NovaPrime18/Twin-GaN/production/bom-after-1210-to-0805.csv

Reference | Value | Footprint | LCSC | Manufacturer Part Number
C1 | 100nF | Capacitor_SMD:C_0402_1005Metric | C307331
C2 | 10uF | Capacitor_SMD:C_0805_2012Metric | C440198
C3 | 100nF | Capacitor_SMD:C_0402_1005Metric | C307331
C4 | 100nF | Capacitor_SMD:C_0402_1005Metric | C307331
C5 | 100nF | Capacitor_SMD:C_0402_1005Metric | C307331
C6 | 100nF | Capacitor_SMD:C_0402_1005Metric | C307331
C7 | 100nF | Capacitor_SMD:C_0402_1005Metric | C307331
C8 | 10uF | Capacitor_SMD:C_0805_2012Metric | C440198
C9 | 2.2uF | Capacitor_SMD:C_0402_1005Metric | C20539421
C10 | 2.2uF | Capacitor_SMD:C_0402_1005Metric | C20539421
C11 | 15pF | Capacitor_SMD:C_0402_1005Metric | C1548
C12 | 15pF | Capacitor_SMD:C_0402_1005Metric | C1548
C13 | 2.2uF | Capacitor_SMD:C_0402_1005Metric | C20539421
C14 | 2.2uF 100V | Capacitor_SMD:C_1206_3216Metric | C170101
C15 | 100nF | Capacitor_SMD:C_0402_1005Metric | C307331
C16 | 100nF | Capacitor_SMD:C_0402_1005Metric | C307331
C17 | 10uF | Capacitor_SMD:C_0805_2012Metric | C440198
C18 | 100nF | Capacitor_SMD:C_0402_1005Metric | C307331
C19 | 2.2uF | Capacitor_SMD:C_0402_1005Metric | C20539421
C20 | 100nF | Capacitor_SMD:C_0402_1005Metric | C307331
C21 | 2.2uF 100V | Capacitor_SMD:C_1206_3216Metric | C170101
C22 | 100nF | Capacitor_SMD:C_0402_1005Metric | C307331
C23 | 2.2uF | Capacitor_SMD:C_0402_1005Metric | C20539421
C24 | 100nF | Capacitor_SMD:C_0402_1005Metric | C307331
C25 | 2.2uF 100V | Capacitor_SMD:C_1206_3216Metric | C170101
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
C95 | 2.2uF | Capacitor_SMD:C_0402_1005Metric | C20539421
C96 | 2.2uF | Capacitor_SMD:C_0402_1005Metric | C20539421
C97 | 100nF | Capacitor_SMD:C_0402_1005Metric | C307331
C98 | 100nF | Capacitor_SMD:C_0402_1005Metric | C307331
C99 | 100nF | Capacitor_SMD:C_0402_1005Metric | C307331
C100 | 2.2uF 100V | Capacitor_SMD:C_1206_3216Metric | C170101
C101 | 2.2uF 100V | Capacitor_SMD:C_1206_3216Metric | C170101
C102 | 2.2uF 100V | Capacitor_SMD:C_1206_3216Metric | C170101
C103 | 100nF | Capacitor_SMD:C_0402_1005Metric | C307331
C104 | 100nF | Capacitor_SMD:C_0402_1005Metric | C307331
C105 | 100nF | Capacitor_SMD:C_0402_1005Metric | C307331
C106 | 100nF | Capacitor_SMD:C_0402_1005Metric | C307331
C107 | 100nF | Capacitor_SMD:C_0402_1005Metric | C307331
C108 | 100nF | Capacitor_SMD:C_0402_1005Metric | C307331
C109 | 100nF | Capacitor_SMD:C_0402_1005Metric | C307331
C110 | 100uF 80V | Capacitor_SMD:CP_Elec_10x10 | C487410
C111 | 100uF 80V | Capacitor_SMD:CP_Elec_10x10 | C487410
C112 | 100uF 80V | Capacitor_SMD:CP_Elec_10x10 | C487410
C113 | 100uF 80V | Capacitor_SMD:CP_Elec_10x10 | C487410
C115 | 100uF 80V | Capacitor_SMD:CP_Elec_10x10 | C487410
C116 | 100uF 80V | Capacitor_SMD:CP_Elec_10x10 | C487410
C117 | 100uF 80V | Capacitor_SMD:CP_Elec_10x10 | C487410
C118 | 100uF 80V | Capacitor_SMD:CP_Elec_10x10 | C487410
D1 | Red | LED_SMD:LED_0603_1608Metric | C2286
D2 | Green | LED_SMD:LED_0603_1608Metric | C84267
D4 | BAV16W | Diode_SMD:D_SOD-123 | C459527
D5 | Red | LED_SMD:LED_0603_1608Metric | C2286
D6 | Green | LED_SMD:LED_0603_1608Metric | C84267
D7 | BAV16W | Diode_SMD:D_SOD-123 | C459527
D8 | BAV16W | Diode_SMD:D_SOD-123 | C459527
D14 | MBR1H100SFT3G | Diode_SMD:D_SOD-123F | C235757 | MBR1H100SFT3G
D22 | LED | LED_SMD:LED_0603_1608Metric | C2286
D23 | MBR1H100SFT3G | Diode_SMD:D_SOD-123F | C235757 | MBR1H100SFT3G
D24 | LED | LED_SMD:LED_0603_1608Metric | C2286
D25 | LED | LED_SMD:LED_0603_1608Metric | C2286
F2 | 0.5A | Resistor_SMD:R_0805_2012Metric | C2833485
F3 | 0.5A | Resistor_SMD:R_0805_2012Metric | C2833485
F4 | 0.5A | Resistor_SMD:R_0805_2012Metric | C2833485
FB2 | 600R@100MHz | Inductor_SMD:L_0402_1005Metric | C76884
FB3 | 600R@100MHz | Inductor_SMD:L_0402_1005Metric | C76884
FB4 | 600R@100MHz | Inductor_SMD:L_0402_1005Metric | C76884
J1 | Conn_01x03 | Connector_AMASS:AMASS_MR30PW-M_1x03_P3.50mm_Horizontal
J3 | Conn_01x04 | Connector_AMASS:AMASS_XT90PW-M_1x02_P10.90mm_Horizontal
J4 | Hall | Connector_JST:JST_PH_B6B-PH-SM4-TB_1x06-1MP_P2.00mm_Vertical | C471518
J5 | COMM | Connector_JST:JST_PH_B8B-PH-SM4-TB_1x08-1MP_P2.00mm_Vertical | C495548
J7 | Connector, USB-TYPE-C-16P | PCM_JLCPCB:TYPE-C-SMD_HX-TYPE-C-16PIN | C2927039
J9 | Hall | Connector_JST:JST_PH_B6B-PH-SM4-TB_1x06-1MP_P2.00mm_Vertical | C471518
J10 | COMM | Connector_JST:JST_PH_B8B-PH-SM4-TB_1x08-1MP_P2.00mm_Vertical | C495548
J11 | Conn_01x03 | Connector_AMASS:AMASS_MR30PW-M_1x03_P3.50mm_Horizontal
J12 | Connector, USB-TYPE-C-16P | PCM_JLCPCB:TYPE-C-SMD_HX-TYPE-C-16PIN | C2927039
J13 | Connector, USB-TYPE-C-16P | PCM_JLCPCB:TYPE-C-SMD_HX-TYPE-C-16PIN | C2927039
L2 | 22uH 1A 0.29Ohm | Inductor_SMD:L_Sunlord_SWPA4030S | C83472 | SWPA4030S220MT
L3 | 22uH 1A 0.29Ohm | Inductor_SMD:L_Sunlord_SWPA4030S | C83472 | SWPA4030S220MT
R1 | 22 | Resistor_SMD:R_0402_1005Metric | C25092
R2 | 1k | Resistor_SMD:R_0402_1005Metric | C11702
R3 | 1k | Resistor_SMD:R_0402_1005Metric | C11702
R10 | 4.7 | Resistor_SMD:R_0402_1005Metric | C25121
R11 | 10k | Resistor_SMD:R_0402_1005Metric | C25744
R12 | 10k | Resistor_SMD:R_0402_1005Metric | C25744
R13 | 22 | Resistor_SMD:R_0402_1005Metric | C25092
R14 | 10k | Resistor_SMD:R_0402_1005Metric | C25744
R15 | 10k | Resistor_SMD:R_0402_1005Metric | C25744
R16 | 22 | Resistor_SMD:R_0402_1005Metric | C25092
R17 | 1k | Resistor_SMD:R_0402_1005Metric | C11702
R18 | 1k | Resistor_SMD:R_0402_1005Metric | C11702
R19 | 22 | Resistor_SMD:R_0402_1005Metric | C25092
R20 | 22 | Resistor_SMD:R_0402_1005Metric | C25092
R21 | 22 | Resistor_SMD:R_0402_1005Metric | C25092
R22 | 22 | Resistor_SMD:R_0402_1005Metric | C25092
R23 | 22 | Resistor_SMD:R_0402_1005Metric | C25092
R30 | 4.7 | Resistor_SMD:R_0402_1005Metric | C25121
R31 | 10k | Resistor_SMD:R_0402_1005Metric | C25744
R32 | 10k | Resistor_SMD:R_0402_1005Metric | C25744
R33 | 10k | Resistor_SMD:R_0402_1005Metric | C25744
R34 | 10k | Resistor_SMD:R_0402_1005Metric | C25744
R35 | 56k | Resistor_SMD:R_0603_1608Metric | C23206
R36 | 2k2 | Resistor_SMD:R_0402_1005Metric | C25879
R37 | 56k | Resistor_SMD:R_0603_1608Metric | C23206
R38 | 2k2 | Resistor_SMD:R_0402_1005Metric | C25879
R39 | 56k | Resistor_SMD:R_0603_1608Metric | C23206
R40 | 2k2 | Resistor_SMD:R_0402_1005Metric | C25879
R41 | 220 | Resistor_SMD:R_0603_1608Metric | C22962
R42 | 22 | Resistor_SMD:R_0402_1005Metric | C25092
R43 | 22 | Resistor_SMD:R_0402_1005Metric | C25092
R44 | 22 | Resistor_SMD:R_0402_1005Metric | C25092
R45 | 22 | Resistor_SMD:R_0402_1005Metric | C25092
R46 | 22 | Resistor_SMD:R_0402_1005Metric | C25092
R47 | 22 | Resistor_SMD:R_0402_1005Metric | C25092
R48 | 10k | Resistor_SMD:R_0402_1005Metric | C25744
R49 | 10k | Resistor_SMD:R_0402_1005Metric | C25744
R50 | 10k | Resistor_SMD:R_0402_1005Metric | C25744
R51 | 100k | Resistor_SMD:R_0402_1005Metric | C60491
R52 | 10 | Resistor_SMD:R_0402_1005Metric | C25077
R53 | 10 | Resistor_SMD:R_0402_1005Metric | C25077
R54 | 10 | Resistor_SMD:R_0402_1005Metric | C25077
R55 | 10 | Resistor_SMD:R_0402_1005Metric | C25077
R56 | 10 | Resistor_SMD:R_0402_1005Metric | C25077
R57 | 10 | Resistor_SMD:R_0402_1005Metric | C25077
R58 | 56k | Resistor_SMD:R_0603_1608Metric | C23206
R59 | 2k2 | Resistor_SMD:R_0402_1005Metric | C25879
R60 | 22 | Resistor_SMD:R_0402_1005Metric | C25092
R61 | 22 | Resistor_SMD:R_0402_1005Metric | C25092
R62 | 22 | Resistor_SMD:R_0402_1005Metric | C25092
R63 | 22 | Resistor_SMD:R_0402_1005Metric | C25092
R64 | 22 | Resistor_SMD:R_0402_1005Metric | C25092
R65 | 22 | Resistor_SMD:R_0402_1005Metric | C25092
R66 | 10 | Resistor_SMD:R_0402_1005Metric | C25077
R67 | 1k | Resistor_SMD:R_0402_1005Metric | C11702
R68 | 1k | Resistor_SMD:R_0402_1005Metric | C11702
R69 | 10 | Resistor_SMD:R_0402_1005Metric | C25077
R70 | 10 | Resistor_SMD:R_0402_1005Metric | C25077
R71 | 10 | Resistor_SMD:R_0402_1005Metric | C25077
R72 | 1k | Resistor_SMD:R_0402_1005Metric | C11702
R73 | 1k | Resistor_SMD:R_0402_1005Metric | C11702
R74 | 10k @25°C | Resistor_SMD:R_0402_1005Metric | C77131
R75 | 10k @25°C | Resistor_SMD:R_0402_1005Metric | C77131
R76 | 10k @25°C | Resistor_SMD:R_0402_1005Metric | C77131
R77 | 1k | Resistor_SMD:R_0402_1005Metric | C106235
R78 | 1k | Resistor_SMD:R_0402_1005Metric | C11702
R79 | 50k | Resistor_SMD:R_0402_1005Metric | C25897
R80 | 1k | Resistor_SMD:R_0402_1005Metric | C11702
R81 | 10k @25°C | Resistor_SMD:R_0402_1005Metric | C77131
R82 | 10k @25°C | Resistor_SMD:R_0402_1005Metric | C77131
R83 | 10k @25°C | Resistor_SMD:R_0402_1005Metric | C77131
R84 | 33k 1% | Resistor_SMD:R_0402_1005Metric | C138003 | RC0402FR-0733KL
R85 | 4.7k 1% | Resistor_SMD:R_0402_1005Metric | C105871 | 0402WGF1003TCE
R86 | 33k 1% | Resistor_SMD:R_0402_1005Metric | C138003 | RC0402FR-0733KL
R87 | 10 | Resistor_SMD:R_0402_1005Metric | C25077
R88 | 10 | Resistor_SMD:R_0402_1005Metric | C25077
R89 | 56k | Resistor_SMD:R_0603_1608Metric | C23206
R90 | 2k2 | Resistor_SMD:R_0402_1005Metric | C25879
R91 | 56k | Resistor_SMD:R_0603_1608Metric | C23206
R92 | 10k | Resistor_SMD:R_0402_1005Metric | C2906861
R93 | 54.9k 1% | Resistor_SMD:R_0402_1005Metric | C11626
R94 | 10k | Resistor_SMD:R_0402_1005Metric | C2906861
R95 | 1k | Resistor_SMD:R_0402_1005Metric | C106235
R96 | 2k2 | Resistor_SMD:R_0402_1005Metric | C25879
R97 | 2mR | Resistor_SMD:R_1206_3216Metric | C601094
R98 | 2mR | Resistor_SMD:R_1206_3216Metric | C601094
R99 | 2mR | Resistor_SMD:R_1206_3216Metric | C601094
R100 | 2mR | Resistor_SMD:R_1206_3216Metric | C601094
R101 | 2mR | Resistor_SMD:R_1206_3216Metric | C601094
R102 | 2mR | Resistor_SMD:R_1206_3216Metric | C601094
R103 | 56k | Resistor_SMD:R_0603_1608Metric | C23206
R104 | 2k2 | Resistor_SMD:R_0402_1005Metric | C25879
R105 | 5.1k | Resistor_SMD:R_0402_1005Metric | C25905
R106 | 5.1k | Resistor_SMD:R_0402_1005Metric | C25905
R107 | 5.1k | Resistor_SMD:R_0402_1005Metric | C25905
R108 | 5.1k | Resistor_SMD:R_0402_1005Metric | C25905
R109 | 5.1k | Resistor_SMD:R_0402_1005Metric | C25905
R110 | 5.1k | Resistor_SMD:R_0402_1005Metric | C25905
SW1 | KMR211NGLFS | Button_Switch_SMD:SW_Push_1P1T_NO_CK_KMR2 | C221676
SW2 | KMR211NGLFS | Button_Switch_SMD:SW_Push_1P1T_NO_CK_KMR2 | C221676
U1 | STM32F405RGTx | Package_QFP:LQFP-64_10x10mm_P0.5mm | C15742
U2 | EPC23102 | Thommys-Parts:D0727
U3 | INA240A1D | Package_SO:SOIC-8_3.9x4.9mm_P1.27mm | C1346458
U4 | STM32F405RGTx | Package_QFP:LQFP-64_10x10mm_P0.5mm | C15742
U5 | EPC23102 | Thommys-Parts:D0727
U6 | EPC23102 | Thommys-Parts:D0727
U7 | TJA1051TK-3 | Package_SON:HVSON-8-1EP_3x3mm_P0.65mm_EP1.6x2.4mm | C2875699
U8 | ESP32-C3-WROOM-02 | RF_Module:ESP32-C3-WROOM-02 | C2934560
U9 | INA240A1D | Package_SO:SOIC-8_3.9x4.9mm_P1.27mm | C1346458
U10 | 74LVC1G66 | Package_TO_SOT_SMD:SOT-353_SC-70-5 | C97489
U11 | 74LVC1G66 | Package_TO_SOT_SMD:SOT-353_SC-70-5 | C97489
U12 | 74LVC1G66 | Package_TO_SOT_SMD:SOT-353_SC-70-5 | C97489
U13 | 74LVC1G66 | Package_TO_SOT_SMD:SOT-353_SC-70-5 | C97489
U14 | 74LVC1G66 | Package_TO_SOT_SMD:SOT-353_SC-70-5 | C97489
U15 | LMR16006XDDCR | Package_TO_SOT_SMD:SOT-23-6 | C87080 | LMR16006XDDCR
U16 | LMR16006XDDCR | Package_TO_SOT_SMD:SOT-23-6 | C87080 | LMR16006XDDCR
U17 | 74LVC1G66 | Package_TO_SOT_SMD:SOT-353_SC-70-5 | C97489
U18 | EPC23102 | Thommys-Parts:D0727
U19 | INA240A1D | Package_SO:SOIC-8_3.9x4.9mm_P1.27mm | C1346458
U20 | 74LVC1G66 | Package_TO_SOT_SMD:SOT-353_SC-70-5 | C97489
U21 | 74LVC1G66 | Package_TO_SOT_SMD:SOT-353_SC-70-5 | C97489
U22 | 74LVC1G66 | Package_TO_SOT_SMD:SOT-353_SC-70-5 | C97489
U23 | 74LVC1G66 | Package_TO_SOT_SMD:SOT-353_SC-70-5 | C97489
U24 | 74LVC1G66 | Package_TO_SOT_SMD:SOT-353_SC-70-5 | C97489
U25 | 74LVC1G66 | Package_TO_SOT_SMD:SOT-353_SC-70-5 | C97489
U26 | EPC23102 | Thommys-Parts:D0727
U27 | EPC23102 | Thommys-Parts:D0727
U28 | INA240A1D | Package_SO:SOIC-8_3.9x4.9mm_P1.27mm | C1346458
U29 | INA240A1D | Package_SO:SOIC-8_3.9x4.9mm_P1.27mm | C1346458
U30 | INA240A1D | Package_SO:SOIC-8_3.9x4.9mm_P1.27mm | C1346458
U31 | TJA1051TK-3 | Package_SON:HVSON-8-1EP_3x3mm_P0.65mm_EP1.6x2.4mm | C2875699
U32 | TJA1051TK-3 | Package_SON:HVSON-8-1EP_3x3mm_P0.65mm_EP1.6x2.4mm | C2875699
Y1 | 8M | Crystal:Crystal_SMD_3225-4Pin_3.2x2.5mm | C2682775
Y2 | 8M | Crystal:Crystal_SMD_3225-4Pin_3.2x2.5mm | C2682775
