NovaPrime18/Twin-GaN/Twin-GaN-VESC.kicad_pcb

## KiCad design Twin-GaN-VESC.kicad_pcb (2026-10-15)

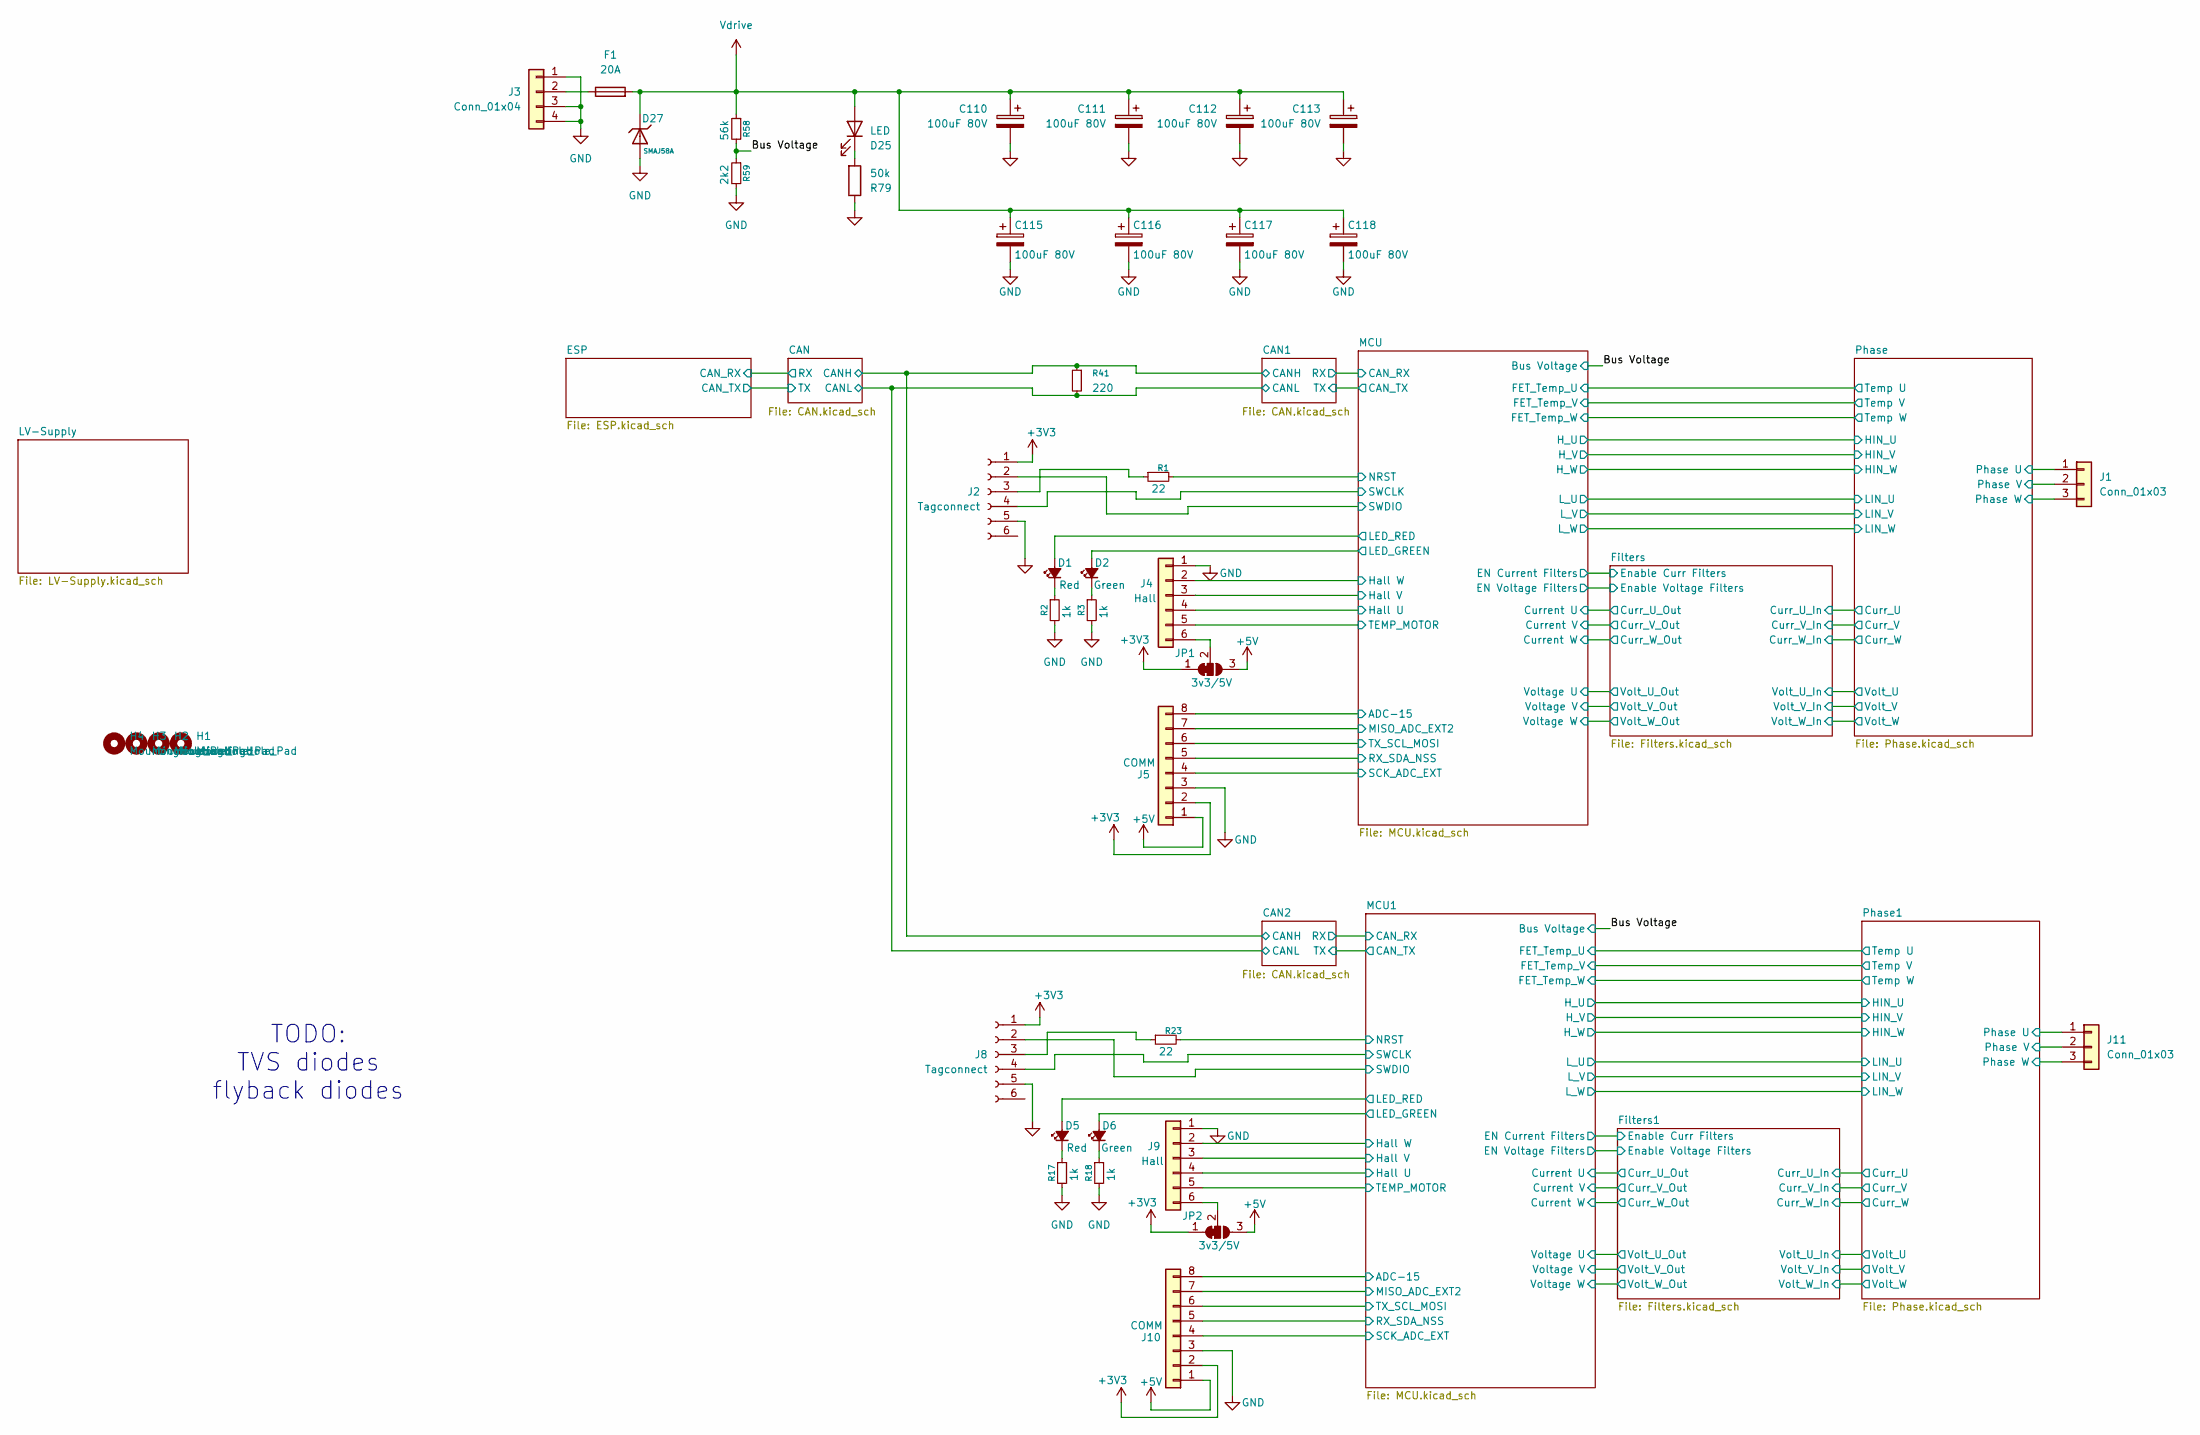
[picture p3: schematic Twin-GaN-VESC.kicad_sch, Twin-GaN]

Parts:
C110, C111, C112, C113, C115, C116, C117, C118: 100uF 80V; CP_Elec_10x10; LCSC C487410
D1, D5: Red; LED_0603_1608Metric; LCSC C2286
D2, D6: Green; LED_0603_1608Metric; LCSC C84267
D25: LED; LED_0603_1608Metric; LCSC C2286
D27: SMAJ58A; D_SMA; Part SMAJ58A; LCSC C19077554
F1: 20A; Fuse_2512_6332Metric; LCSC C49269483
H1, H2, H3, H4: MountingHole_Pad; MountingHole_2.7mm_M2.5
J1, J11: Conn_01x03; AMASS_MR30PW-M_1x03_P3.50mm_Horizontal
J2, J8: Tagconnect; Tag-Connect_TC2030-IDC-NL_2x03_P1.27mm_Vertical
J3: Conn_01x04; AMASS_XT60IPW-M_1x03_P7.20mm_Horizontal
J4, J9: Hall; JST_PH_B6B-PH-SM4-TB_1x06-1MP_P2.00mm_Vertical; LCSC C471518
J5, J10: COMM; JST_PH_B8B-PH-SM4-TB_1x08-1MP_P2.00mm_Vertical; LCSC C495548
JP1, JP2: 3v3/5V; SolderJumper-3_P1.3mm_Bridged12_RoundedPad1.0x1.5mm
R1, R23: 22; R_0402_1005Metric; LCSC C25092
R2, R3, R17, R18: 1k; R_0402_1005Metric; LCSC C11702
R41: 220; R_0603_1608Metric; LCSC C22962
R58: 56k; R_0603_1608Metric; LCSC C23206
R59: 2k2; R_0402_1005Metric; LCSC C25879
R79: 50k; R_0402_1005Metric; LCSC C25897

Connections:
+3V3: J2.1, J5.2, J8.1, J10.2, JP1.1 (A), JP2.1 (A); also elsewhere on the board
+5V: J5.1, J10.1, JP1.3 (B), JP2.3 (B); also elsewhere on the board
/Bus Voltage: R58.2, R59.1; also elsewhere on the board
/CAN/CANH: R41.1; also elsewhere on the board
/CAN/CANL: R41.2; also elsewhere on the board
/MCU1/ADC-15: J10.8; also elsewhere on the board
/MCU1/Hall U: J9.4; also elsewhere on the board
/MCU1/Hall V: J9.3; also elsewhere on the board
/MCU1/Hall W: J9.2; also elsewhere on the board
/MCU1/LED_GREEN: D6.2 (A); also elsewhere on the board
/MCU1/LED_RED: D5.2 (A); also elsewhere on the board
/MCU1/MISO_ADC_EXT2: J10.7; also elsewhere on the board
/MCU1/NRST: R23.2; also elsewhere on the board
/MCU1/RX_SDA_NSS: J10.5; also elsewhere on the board
/MCU1/SCK_ADC_EXT: J10.4; also elsewhere on the board
/MCU1/SWCLK: J8.4; also elsewhere on the board
/MCU1/SWDIO: J8.2; also elsewhere on the board
/MCU1/TEMP_MOTOR: J9.5; also elsewhere on the board
/MCU1/TX_SCL_MOSI: J10.6; also elsewhere on the board
/MCU/ADC-15: J5.8; also elsewhere on the board
/MCU/Hall U: J4.4; also elsewhere on the board
/MCU/Hall V: J4.3; also elsewhere on the board
/MCU/Hall W: J4.2; also elsewhere on the board
/MCU/LED_GREEN: D2.2 (A); also elsewhere on the board
/MCU/LED_RED: D1.2 (A); also elsewhere on the board
/MCU/MISO_ADC_EXT2: J5.7; also elsewhere on the board
/MCU/NRST: R1.2; also elsewhere on the board
/MCU/RX_SDA_NSS: J5.5; also elsewhere on the board
/MCU/SCK_ADC_EXT: J5.4; also elsewhere on the board
/MCU/SWCLK: J2.4; also elsewhere on the board
/MCU/SWDIO: J2.2; also elsewhere on the board
/MCU/TEMP_MOTOR: J4.5; also elsewhere on the board
/MCU/TX_SCL_MOSI: J5.6; also elsewhere on the board
/Phase1/Phase U: J11.1; also elsewhere on the board
/Phase1/Phase V: J11.2; also elsewhere on the board
/Phase1/Phase W: J11.3; also elsewhere on the board
/Phase/Phase U: J1.1; also elsewhere on the board
/Phase/Phase V: J1.2; also elsewhere on the board
/Phase/Phase W: J1.3; also elsewhere on the board
GND: C110.2, C111.2, C112.2, C113.2, C115.2, C116.2, C117.2, C118.2, D27.2, J2.5, J3.1, J3.3, J3.4, J4.1, J5.3, J8.5, J9.1, J10.3, R2.2, R3.2, R17.2, R18.2, R59.2, R79.1; also elsewhere on the board
unnamed: D1.1 (K), R2.1
unnamed: D2.1 (K), R3.1
unnamed: D5.1 (K), R17.1
unnamed: D6.1 (K), R18.1
unnamed: D25.1 (K), R79.2
unnamed: J2.3, R1.1
unnamed: F1.1, J3.2
unnamed: J4.6, JP1.2 (C)
unnamed: J8.3, R23.1
unnamed: J9.6, JP2.2 (C)
Vdrive: C110.1, C111.1, C112.1, C113.1, C115.1, C116.1, C117.1, C118.1, D25.2 (A), D27.1, F1.2, R58.1; also elsewhere on the board

Notes on the sheet:
TODO: TVS diodes flyback diodes

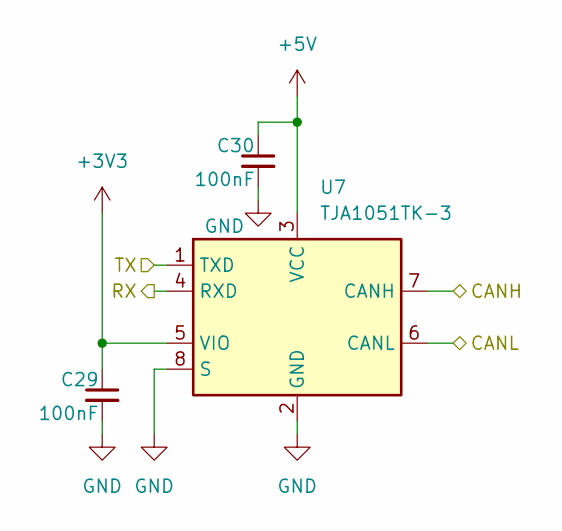
[picture p4: schematic CAN.kicad_sch, Twin-GaN]

Parts:
C29, C30: 100nF; C_0402_1005Metric; LCSC C307331
U7: TJA1051TK-3; HVSON-8-1EP_3x3mm_P0.65mm_EP1.6x2.4mm; JLC C2875699

Connections:
+3V3: C29.1, U7.5 (VIO); also elsewhere on the board
+5V: C30.1, U7.3 (VCC); also elsewhere on the board
/CAN/CANH: U7.7 (CANH); also elsewhere on the board
/CAN/CANL: U7.6 (CANL); also elsewhere on the board
/CAN/RX: U7.4 (RXD); also elsewhere on the board
/CAN/TX: U7.1 (TXD); also elsewhere on the board
GND: C29.2, C30.2, U7.2 (GND), U7.8 (S), U7.9 (GND); also elsewhere on the board

Parts of its further copies:
C106, C107, C108, C109: 100nF; C_0402_1005Metric; LCSC C307331
U31, U32: TJA1051TK-3; HVSON-8-1EP_3x3mm_P0.65mm_EP1.6x2.4mm; JLC C2875699

Connections of its further copies:
+3V3: C106.1, C108.1, U31.5 (VIO), U32.5 (VIO); also elsewhere on the board
+5V: C107.1, C109.1, U31.3 (VCC), U32.3 (VCC); also elsewhere on the board
/CAN1/RX: U31.4 (RXD); also elsewhere on the board
/CAN1/TX: U31.1 (TXD); also elsewhere on the board
/CAN2/RX: U32.4 (RXD); also elsewhere on the board
/CAN2/TX: U32.1 (TXD); also elsewhere on the board
/CAN/CANH: U31.7 (CANH), U32.7 (CANH); also elsewhere on the board
/CAN/CANL: U31.6 (CANL), U32.6 (CANL); also elsewhere on the board
GND: C106.2, C107.2, C108.2, C109.2, U31.2 (GND), U31.8 (S), U31.9 (GND), U32.2 (GND), U32.8 (S), U32.9 (GND); also elsewhere on the board

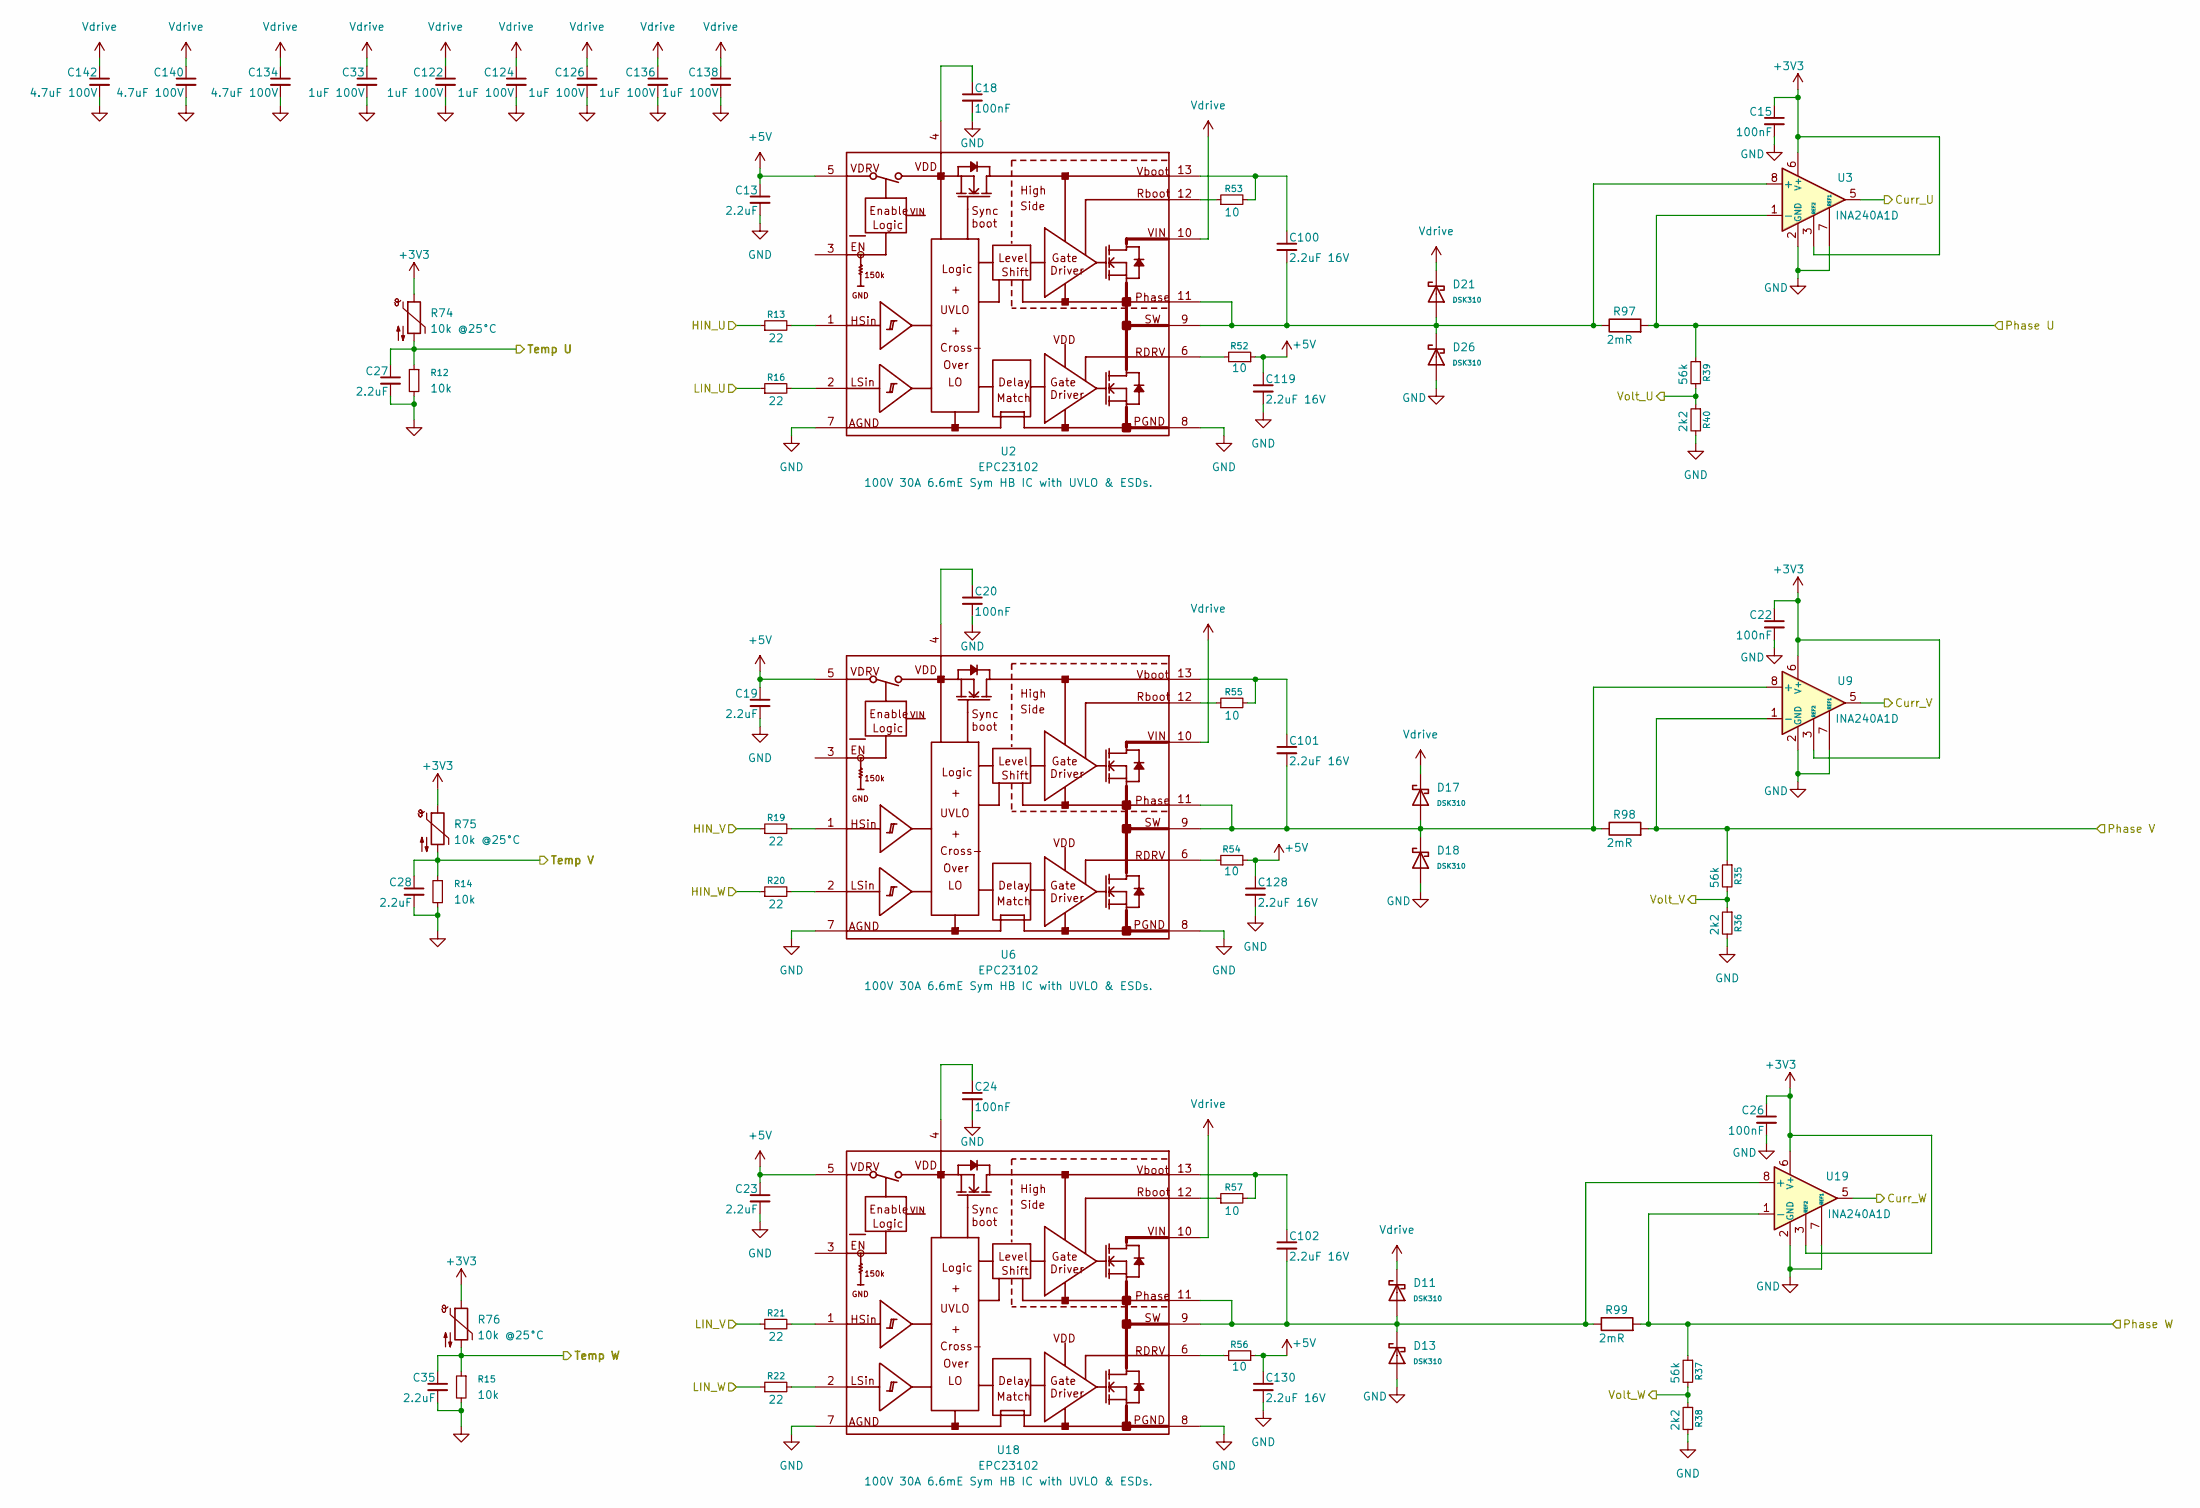
[picture p5: schematic Phase.kicad_sch, Twin-GaN]

Parts:
C13, C19, C23, C27, C28, C35: 2.2uF; C_0402_1005Metric; LCSC C20539421
C15, C18, C20, C22, C24, C26: 100nF; C_0402_1005Metric; LCSC C307331
C33, C122, C124, C126, C136, C138: 1uF 100V; C_0805_2012Metric; LCSC C5370002
C100, C101, C102, C119, C128, C130: 2.2uF 16V; C_0402_1005Metric; LCSC C307418
C134, C140, C142: 4.7uF 100V; C_1206_3216Metric; LCSC C22367839
D11, D13, D17, D18, D21, D26: DSK310; D_SOD-123F; Part SS28; LCSC C28646289
R12, R14, R15: 10k; R_0402_1005Metric; LCSC C25744
R13, R16, R19, R20, R21, R22: 22; R_0402_1005Metric; LCSC C25092
R35, R37, R39: 56k; R_0603_1608Metric; LCSC C23206
R36, R38, R40: 2k2; R_0402_1005Metric; LCSC C25879
R52, R53, R54, R55, R56, R57: 10; R_0402_1005Metric; LCSC C25077
R74, R75, R76: 10k @25°C; R_0402_1005Metric; LCSC C77131
R97, R98, R99: 2mR; R_1206_3216Metric; LCSC C601094
U2, U6, U18: EPC23102; D0727
U3, U9, U19: INA240A1D; SOIC-8_3.9x4.9mm_P1.27mm; LCSC C1346458

Connections:
+3V3: C15.1, C22.1, C26.1, R74.1, R75.1, R76.1, U3.3 (REF2), U3.6 (V+), U9.3 (REF2), U9.6 (V+), U19.3 (REF2), U19.6 (V+); also elsewhere on the board
+5V: C13.1, C19.1, C23.1, C119.1, C128.1, C130.1, R52.1, R54.1, R56.1, U2.5 (VDRV), U6.5 (VDRV), U18.5 (VDRV); also elsewhere on the board
/Filters/Curr_U_In: U3.5; also elsewhere on the board
/Filters/Curr_V_In: U9.5; also elsewhere on the board
/Filters/Curr_W_In: U19.5; also elsewhere on the board
/Filters/Volt_U_In: R39.2, R40.1; also elsewhere on the board
/Filters/Volt_V_In: R35.2, R36.1; also elsewhere on the board
/Filters/Volt_W_In: R37.2, R38.1; also elsewhere on the board
/MCU/FET_Temp_U: C27.1, R12.1, R74.2; also elsewhere on the board
/MCU/FET_Temp_V: C28.1, R14.1, R75.2; also elsewhere on the board
/MCU/FET_Temp_W: C35.1, R15.1, R76.2; also elsewhere on the board
/MCU/H_U: R13.1; also elsewhere on the board
/MCU/H_V: R19.1; also elsewhere on the board
/MCU/H_W: R20.1; also elsewhere on the board
/MCU/L_U: R16.1; also elsewhere on the board
/MCU/L_V: R21.1; also elsewhere on the board
/MCU/L_W: R22.1; also elsewhere on the board
/Phase/Phase U: R39.1, R97.2, U3.1 (-); also elsewhere on the board
/Phase/Phase V: R35.1, R98.2, U9.1 (-); also elsewhere on the board
/Phase/Phase W: R37.1, R99.2, U19.1 (-); also elsewhere on the board
GND: C13.2, C15.2, C18.2, C19.2, C20.2, C22.2, C23.2, C24.2, C26.2, C27.2, C28.2, C33.2, C35.2, C119.2, C122.2, C124.2, C126.2, C128.2, C130.2, C134.2, C136.2, C138.2, C140.2, C142.2, D13.2, D18.2, D26.2, R12.2, R14.2, R15.2, R36.2, R38.2, R40.2, U2.7 (AGND), U2.8 (PGND), U3.2 (GND), U3.4 (GND), U3.7 (REF1), U6.7 (AGND), U6.8 (PGND), U9.2 (GND), U9.4 (GND), U9.7 (REF1), U18.7 (AGND), U18.8 (PGND), U19.2 (GND), U19.4 (GND), U19.7 (REF1); also elsewhere on the board
unnamed: R13.2, U2.1 (HSin)
unnamed: R16.2, U2.2 (LSin)
unnamed: C100.2, D21.2, D26.1, R97.1, U2.9 (SW), U2.11 (Phase), U3.8 (+)
unnamed: R52.2, U2.6 (RDRV)
unnamed: R53.1, U2.12 (Rboot)
unnamed: C18.1, U2.4 (VDD)
unnamed: C100.1, R53.2, U2.13 (Vboot)
unnamed: R19.2, U6.1 (HSin)
unnamed: R20.2, U6.2 (LSin)
unnamed: C101.2, D17.2, D18.1, R98.1, U6.9 (SW), U6.11 (Phase), U9.8 (+)
unnamed: R54.2, U6.6 (RDRV)
unnamed: R55.1, U6.12 (Rboot)
unnamed: C20.1, U6.4 (VDD)
unnamed: C101.1, R55.2, U6.13 (Vboot)
unnamed: R21.2, U18.1 (HSin)
unnamed: R22.2, U18.2 (LSin)
unnamed: C102.2, D11.2, D13.1, R99.1, U18.9 (SW), U18.11 (Phase), U19.8 (+)
unnamed: R56.2, U18.6 (RDRV)
unnamed: R57.1, U18.12 (Rboot)
unnamed: C24.1, U18.4 (VDD)
unnamed: C102.1, R57.2, U18.13 (Vboot)
Vdrive: C33.1, C122.1, C124.1, C126.1, C134.1, C136.1, C138.1, C140.1, C142.1, D11.1, D17.1, D21.1, U2.10 (VIN), U6.10 (VIN), U18.10 (VIN); also elsewhere on the board

Parts of its further copies:
C46, C85, C89, C94, C95, C96: 2.2uF; C_0402_1005Metric; LCSC C20539421
C97, C98, C99, C103, C104, C105: 100nF; C_0402_1005Metric; LCSC C307331
C114, C120, C129, C131, C132, C133: 2.2uF 16V; C_0402_1005Metric; LCSC C307418
C121, C123, C125, C127, C137, C139: 1uF 100V; C_0805_2012Metric; LCSC C5370002
C135, C141, C143: 4.7uF 100V; C_1206_3216Metric; LCSC C22367839
D12, D15, D19, D20, D28, D29: DSK310; D_SOD-123F; Part SS28; LCSC C28646289
R32, R33, R34: 10k; R_0402_1005Metric; LCSC C25744
R60, R61, R62, R63, R64, R65: 22; R_0402_1005Metric; LCSC C25092
R66, R69, R70, R71, R87, R88: 10; R_0402_1005Metric; LCSC C25077
R81, R82, R83: 10k @25°C; R_0402_1005Metric; LCSC C77131
R89, R91, R103: 56k; R_0603_1608Metric; LCSC C23206
R90, R96, R104: 2k2; R_0402_1005Metric; LCSC C25879
R100, R101, R102: 2mR; R_1206_3216Metric; LCSC C601094
U5, U26, U27: EPC23102; D0727
U28, U29, U30: INA240A1D; SOIC-8_3.9x4.9mm_P1.27mm; LCSC C1346458

Connections of its further copies:
+3V3: C103.1, C104.1, C105.1, R81.1, R82.1, R83.1, U28.3 (REF2), U28.6 (V+), U29.3 (REF2), U29.6 (V+), U30.3 (REF2), U30.6 (V+); also elsewhere on the board
+5V: C94.1, C95.1, C96.1, C120.1, C129.1, C131.1, R66.1, R69.1, R70.1, U5.5 (VDRV), U26.5 (VDRV), U27.5 (VDRV); also elsewhere on the board
/Filters1/Curr_U_In: U28.5; also elsewhere on the board
/Filters1/Curr_V_In: U29.5; also elsewhere on the board
/Filters1/Curr_W_In: U30.5; also elsewhere on the board
/Filters1/Volt_U_In: R89.2, R90.1; also elsewhere on the board
/Filters1/Volt_V_In: R103.2, R104.1; also elsewhere on the board
/Filters1/Volt_W_In: R91.2, R96.1; also elsewhere on the board
/MCU1/FET_Temp_U: C46.1, R32.1, R81.2; also elsewhere on the board
/MCU1/FET_Temp_V: C85.1, R33.1, R82.2; also elsewhere on the board
/MCU1/FET_Temp_W: C89.1, R34.1, R83.2; also elsewhere on the board
/MCU1/H_U: R60.1; also elsewhere on the board
/MCU1/H_V: R62.1; also elsewhere on the board
/MCU1/H_W: R63.1; also elsewhere on the board
/MCU1/L_U: R61.1; also elsewhere on the board
/MCU1/L_V: R64.1; also elsewhere on the board
/MCU1/L_W: R65.1; also elsewhere on the board
/Phase1/Phase U: R89.1, R100.2, U28.1 (-); also elsewhere on the board
/Phase1/Phase V: R101.2, R103.1, U29.1 (-); also elsewhere on the board
/Phase1/Phase W: R91.1, R102.2, U30.1 (-); also elsewhere on the board
GND: C46.2, C85.2, C89.2, C94.2, C95.2, C96.2, C97.2, C98.2, C99.2, C103.2, C104.2, C105.2, C120.2, C121.2, C123.2, C125.2, C127.2, C129.2, C131.2, C135.2, C137.2, C139.2, C141.2, C143.2, D15.2, D20.2, D29.2, R32.2, R33.2, R34.2, R90.2, R96.2, R104.2, U5.7 (AGND), U5.8 (PGND), U26.7 (AGND), U26.8 (PGND), U27.7 (AGND), U27.8 (PGND), U28.2 (GND), U28.4 (GND), U28.7 (REF1), U29.2 (GND), U29.4 (GND), U29.7 (REF1), U30.2 (GND), U30.4 (GND), U30.7 (REF1); also elsewhere on the board
unnamed: R60.2, U5.1 (HSin)
unnamed: R61.2, U5.2 (LSin)
unnamed: R66.2, U5.6 (RDRV)
unnamed: R71.1, U5.12 (Rboot)
unnamed: C97.1, U5.4 (VDD)
unnamed: C114.1, R71.2, U5.13 (Vboot)
unnamed: R62.2, U26.1 (HSin)
unnamed: R63.2, U26.2 (LSin)
unnamed: C132.2, D19.2, D20.1, R101.1, U26.9 (SW), U26.11 (Phase), U29.8 (+)
unnamed: R69.2, U26.6 (RDRV)
unnamed: R87.1, U26.12 (Rboot)
unnamed: C98.1, U26.4 (VDD)
unnamed: C132.1, R87.2, U26.13 (Vboot)
unnamed: R64.2, U27.1 (HSin)
unnamed: R65.2, U27.2 (LSin)
unnamed: C133.2, D12.2, D15.1, R102.1, U27.9 (SW), U27.11 (Phase), U30.8 (+)
unnamed: R70.2, U27.6 (RDRV)
unnamed: R88.1, U27.12 (Rboot)
unnamed: C99.1, U27.4 (VDD)
unnamed: C133.1, R88.2, U27.13 (Vboot)
unnamed: C114.2, D28.2, D29.1, R100.1, U5.9 (SW), U5.11 (Phase), U28.8 (+)
Vdrive: C121.1, C123.1, C125.1, C127.1, C135.1, C137.1, C139.1, C141.1, C143.1, D12.1, D19.1, D28.1, U5.10 (VIN), U26.10 (VIN), U27.10 (VIN); also elsewhere on the board

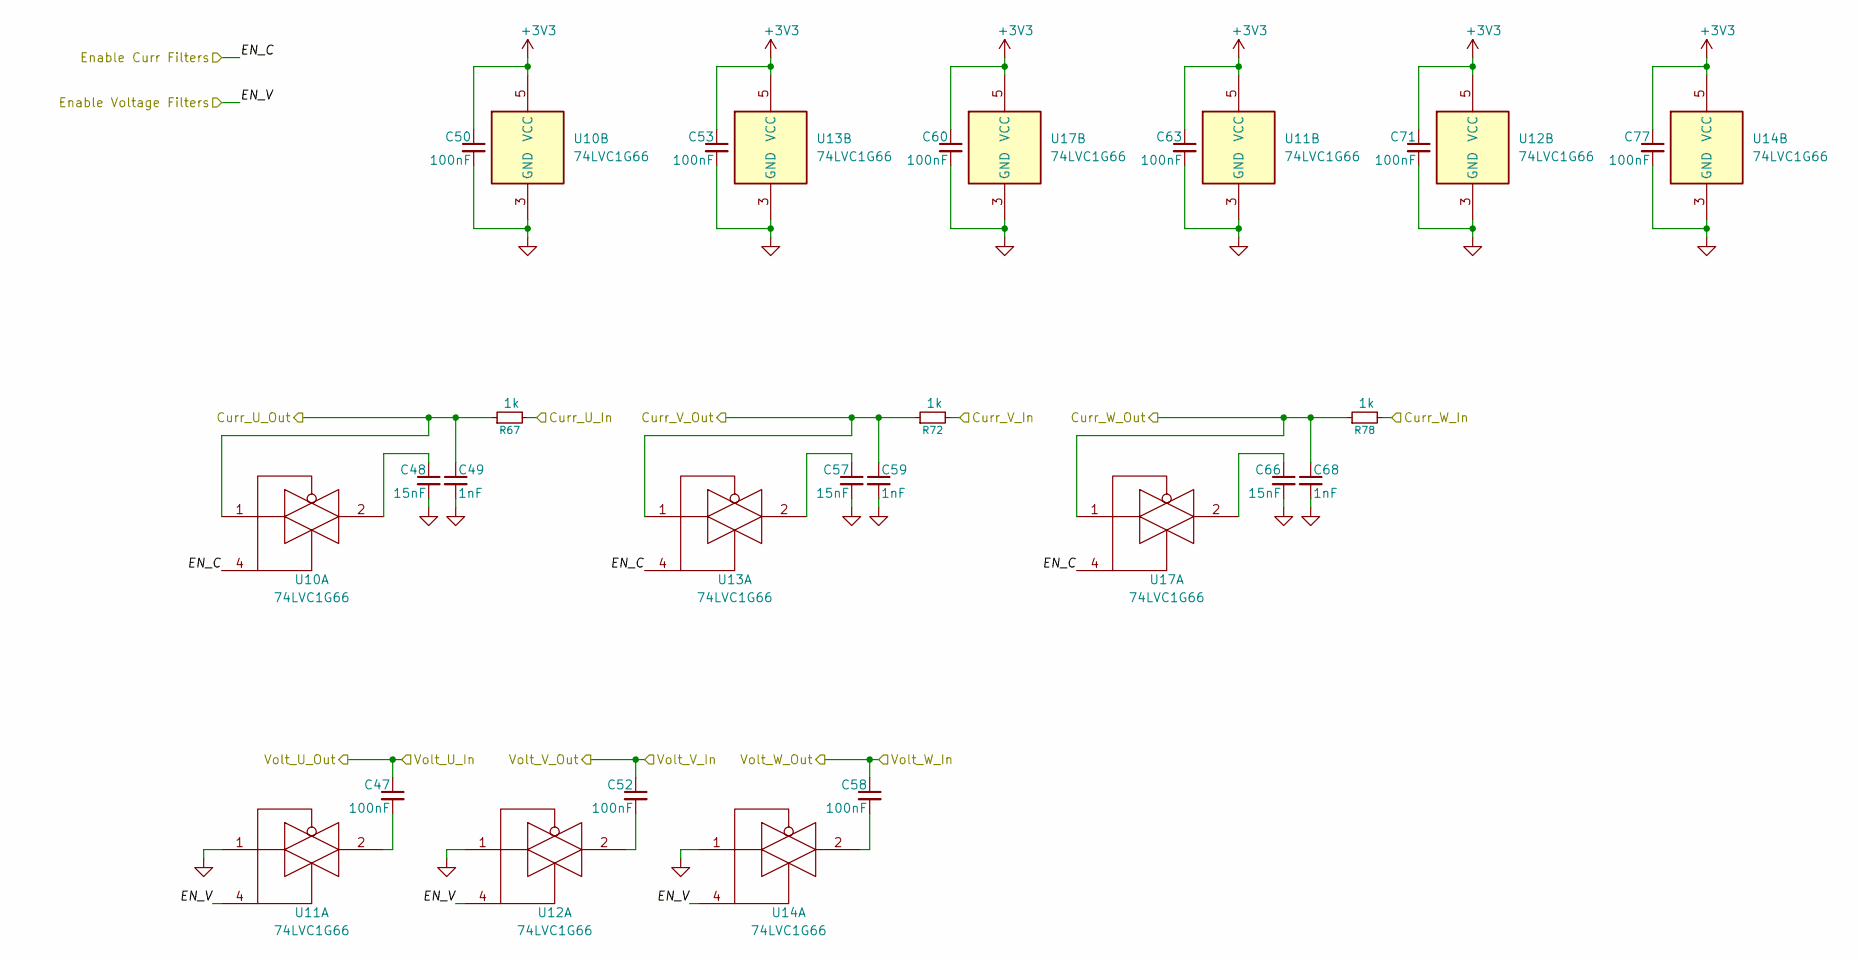
[picture p6: schematic Filters.kicad_sch, Twin-GaN]

Parts:
C47, C50, C52, C53, C58, C60, C63, C71, C77: 100nF; C_0402_1005Metric; LCSC C307331
C48, C57, C66: 15nF; C_0402_1005Metric; LCSC C114405
C49, C59, C68: 1nF; C_0402_1005Metric; LCSC C1523
R67, R72, R78: 1k; R_0402_1005Metric; LCSC C11702
U10, U11, U12, U13, U14, U17: 74LVC1G66; SOT-353_SC-70-5; JLC C97489

Connections:
+3V3: C50.1, C53.1, C60.1, C63.1, C71.1, C77.1, U10.5 (VCC), U11.5 (VCC), U12.5 (VCC), U13.5 (VCC), U14.5 (VCC), U17.5 (VCC); also elsewhere on the board
/Filters/Curr_U_In: R67.2; also elsewhere on the board
/Filters/Curr_U_Out: C49.1, R67.1, U10.1; also elsewhere on the board
/Filters/Curr_V_In: R72.2; also elsewhere on the board
/Filters/Curr_V_Out: C59.1, R72.1, U13.1; also elsewhere on the board
/Filters/Curr_W_In: R78.2; also elsewhere on the board
/Filters/Curr_W_Out: C68.1, R78.1, U17.1; also elsewhere on the board
/Filters/EN_C: U10.4, U13.4, U17.4; also elsewhere on the board
/Filters/EN_V: U11.4, U12.4, U14.4; also elsewhere on the board
/Filters/Volt_U_In: C47.1; also elsewhere on the board
/Filters/Volt_V_In: C52.1; also elsewhere on the board
/Filters/Volt_W_In: C58.1; also elsewhere on the board
GND: C48.2, C49.2, C50.2, C53.2, C57.2, C59.2, C60.2, C63.2, C66.2, C68.2, C71.2, C77.2, U10.3 (GND), U11.1, U11.3 (GND), U12.1, U12.3 (GND), U13.3 (GND), U14.1, U14.3 (GND), U17.3 (GND); also elsewhere on the board
unnamed: C47.2, U11.2
unnamed: C48.1, U10.2
unnamed: C52.2, U12.2
unnamed: C57.1, U13.2
unnamed: C58.2, U14.2
unnamed: C66.1, U17.2

Parts of its further copies:
C51, C70, C73, C74, C76, C79, C80, C83, C84: 100nF; C_0402_1005Metric; LCSC C307331
C54, C75, C81: 15nF; C_0402_1005Metric; LCSC C114405
C67, C78, C82: 1nF; C_0402_1005Metric; LCSC C1523
R68, R73, R80: 1k; R_0402_1005Metric; LCSC C11702
U20, U21, U22, U23, U24, U25: 74LVC1G66; SOT-353_SC-70-5; JLC C97489

Connections of its further copies:
+3V3: C70.1, C74.1, C79.1, C80.1, C83.1, C84.1, U20.5 (VCC), U21.5 (VCC), U22.5 (VCC), U23.5 (VCC), U24.5 (VCC), U25.5 (VCC); also elsewhere on the board
/Filters1/Curr_U_In: R68.2; also elsewhere on the board
/Filters1/Curr_U_Out: C67.1, R68.1, U20.1; also elsewhere on the board
/Filters1/Curr_V_In: R73.2; also elsewhere on the board
/Filters1/Curr_V_Out: C78.1, R73.1, U23.1; also elsewhere on the board
/Filters1/Curr_W_In: R80.2; also elsewhere on the board
/Filters1/Curr_W_Out: C82.1, R80.1, U25.1; also elsewhere on the board
/Filters1/EN_C: U20.4, U23.4, U25.4; also elsewhere on the board
/Filters1/EN_V: U21.4, U22.4, U24.4; also elsewhere on the board
/Filters1/Volt_U_In: C51.1; also elsewhere on the board
/Filters1/Volt_V_In: C73.1; also elsewhere on the board
/Filters1/Volt_W_In: C76.1; also elsewhere on the board
GND: C54.2, C67.2, C70.2, C74.2, C75.2, C78.2, C79.2, C80.2, C81.2, C82.2, C83.2, C84.2, U20.3 (GND), U21.1, U21.3 (GND), U22.1, U22.3 (GND), U23.3 (GND), U24.1, U24.3 (GND), U25.3 (GND); also elsewhere on the board
unnamed: C51.2, U21.2
unnamed: C54.1, U20.2
unnamed: C73.2, U22.2
unnamed: C75.1, U23.2
unnamed: C76.2, U24.2
unnamed: C81.1, U25.2

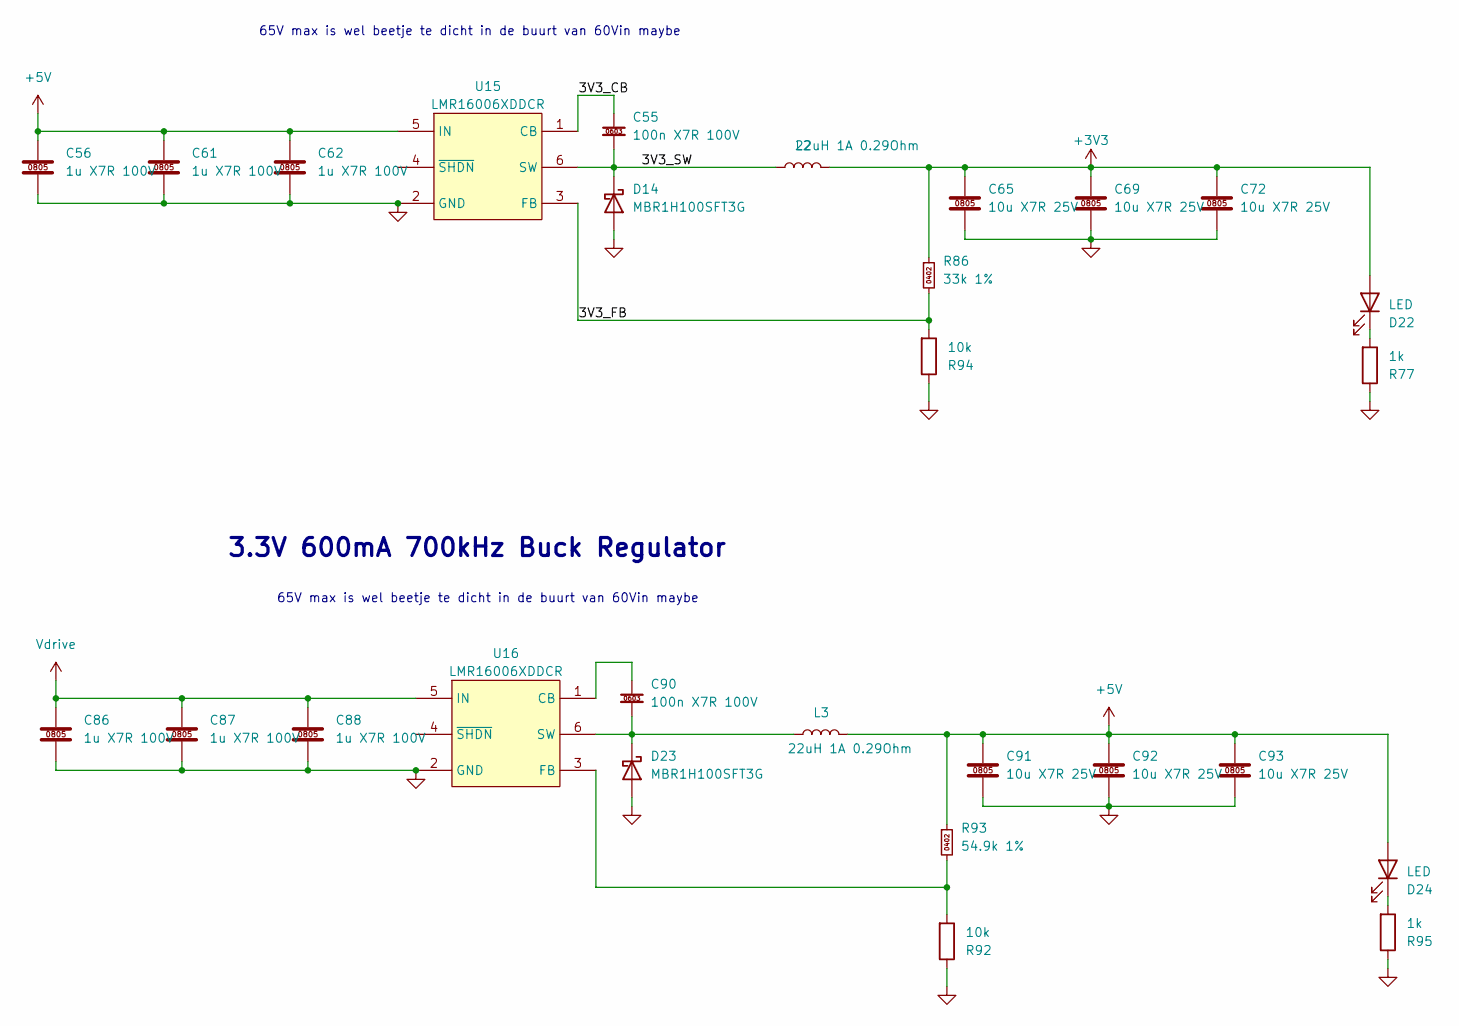
[picture p7: schematic LV-Supply.kicad_sch, Twin-GaN]

Parts:
C55, C90: 100n X7R 100V; C_0603_1608Metric; Manufacturer Part Number CL10B104KC8NNNC; LCSC C15725
C56, C61, C62, C86, C87, C88: 1u X7R 100V; C_0805_2012Metric; Manufacturer Part Number CC0805KKX7R0BB105; LCSC C5370002
C65, C69, C72, C91, C92, C93: 10u X7R 25V; C_0805_2012Metric; Manufacturer Part Number CL21B106KAYQNNE; LCSC C3039694
D14, D23: MBR1H100SFT3G; D_SOD-123F; Manufacturer Part Number MBR1H100SFT3G; LCSC C235757
D22, D24: LED; LED_0603_1608Metric; LCSC C2286
L2, L3: 22uH 1A 0.29Ohm; L_Sunlord_SWPA4030S; Manufacturer Part Number SWPA4030S220MT; LCSC C167883
R77, R95: 1k; R_0402_1005Metric; LCSC C106235
R86: 33k 1%; R_0402_1005Metric; Manufacturer Part Number RC0402FR-0733KL; LCSC C138003
R92, R94: 10k; R_0402_1005Metric; LCSC C2906861
R93: 54.9k 1%; R_0402_1005Metric; LCSC C11626
U15, U16: LMR16006XDDCR; SOT-23-6; Manufacturer Part Number LMR16006XDDCR; LCSC C87080

Connections:
+3V3: C65.1, C69.1, C72.1, D22.2 (A), L2.2, R86.1; also elsewhere on the board
+5V: C56.1, C61.1, C62.1, C91.1, C92.1, C93.1, D24.2 (A), L3.2, R93.1, U15.5 (IN); also elsewhere on the board
/LV-Supply/3V3_CB: C55.1, U15.1 (CB)
/LV-Supply/3V3_FB: R86.2, R94.2, U15.3 (FB)
/LV-Supply/3V3_SW: C55.2, D14.1 (K), L2.1, U15.6 (SW)
GND: C56.2, C61.2, C62.2, C65.2, C69.2, C72.2, C86.2, C87.2, C88.2, C91.2, C92.2, C93.2, D14.2 (A), D23.2 (A), R77.1, R92.1, R94.1, R95.1, U15.2 (GND), U16.2 (GND); also elsewhere on the board
unnamed: D22.1 (K), R77.2
unnamed: C90.2, D23.1 (K), L3.1, U16.6 (SW)
unnamed: D24.1 (K), R95.2
unnamed: C90.1, U16.1 (CB)
unnamed: R92.2, R93.2, U16.3 (FB)
Vdrive: C86.1, C87.1, C88.1, U16.5 (IN); also elsewhere on the board

Notes on the sheet:
65V max is wel beetje te dicht in de buurt van 60Vin maybe
3.3V 600mA 700kHz Buck Regulator
