NovaPrime18/Twin-GaN/Twin-GaN-VESC.kicad_pcb

## KiCad design Twin-GaN-VESC.kicad_pcb (continued)

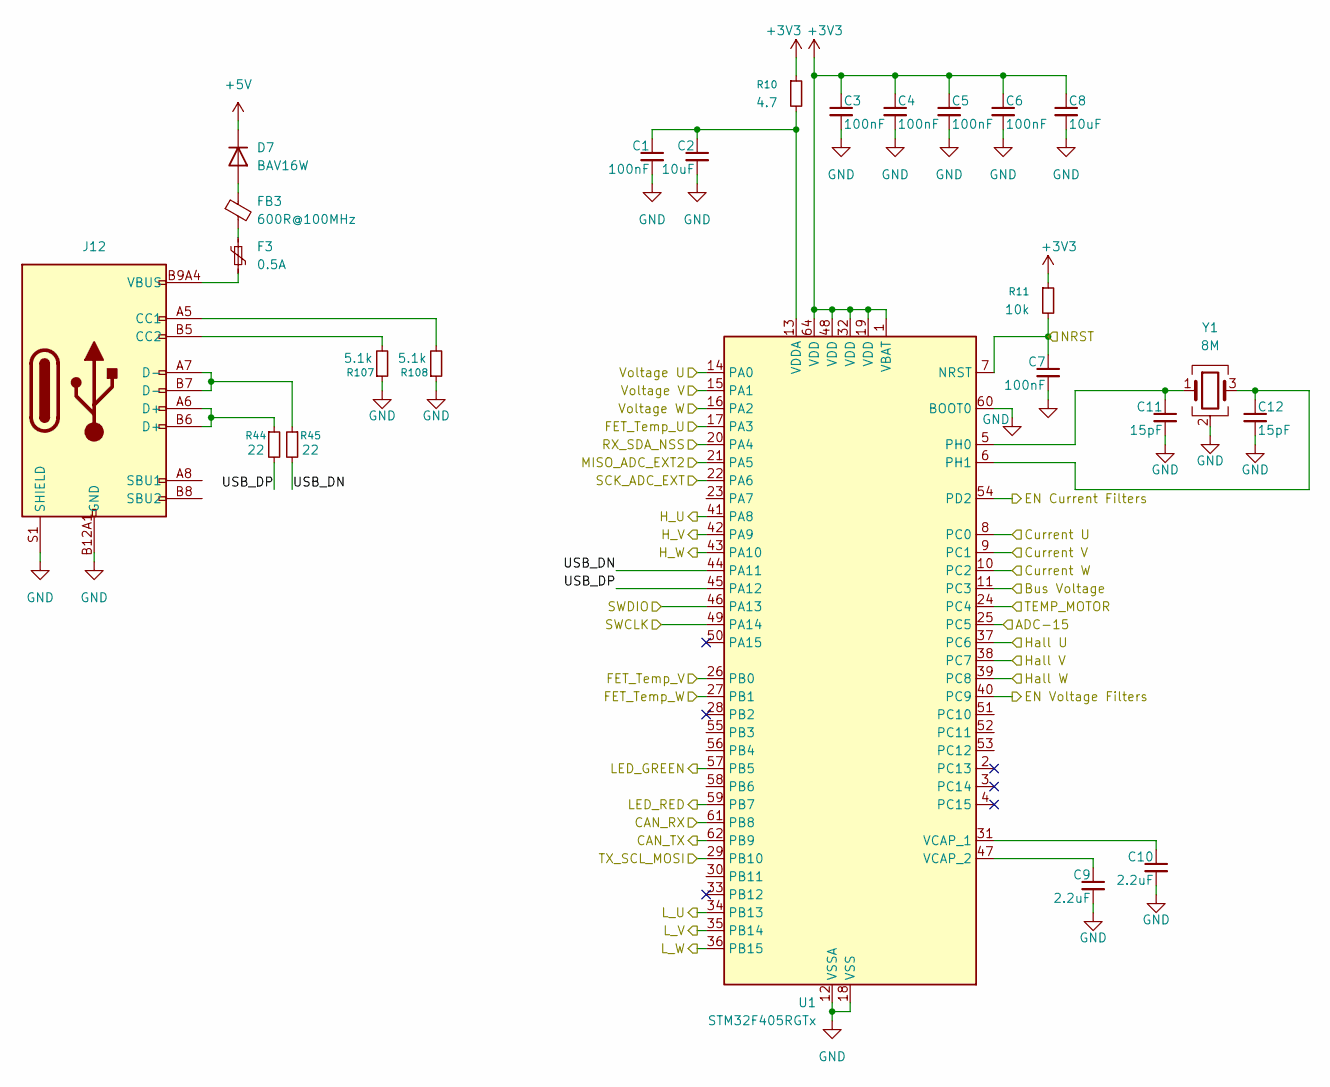
[picture p8: schematic MCU.kicad_sch, Twin-GaN]

Parts:
C1, C3, C4, C5, C6, C7: 100nF; C_0402_1005Metric; LCSC C307331
C2, C8: 10uF; C_0805_2012Metric; LCSC C440198
C9, C10: 2.2uF; C_0402_1005Metric; LCSC C20539421
C11, C12: 15pF; C_0402_1005Metric; LCSC C1548
D7: BAV16W; D_SOD-123; JLC C459527
F3: 0.5A; R_0805_2012Metric; JLC C2833485
FB3: 600R@100MHz; L_0402_1005Metric; LCSC C76884
J12: Connector, USB-TYPE-C-16P; TYPE-C-SMD_HX-TYPE-C-16PIN; LCSC C2927039
R10: 4.7; R_0402_1005Metric; LCSC C25121
R11: 10k; R_0402_1005Metric; LCSC C25744
R44, R45: 22; R_0402_1005Metric; LCSC C25092
R107, R108: 5.1k; R_0402_1005Metric; LCSC C25905
U1: STM32F405RGTx; LQFP-64_10x10mm_P0.5mm; LCSC C15742
Y1: 8M; Crystal_SMD_3225-4Pin_3.2x2.5mm; JLC C2682775

Connections:
+3V3: C3.1, C4.1, C5.1, C6.1, C8.1, R10.1, R11.1, U1.1 (VBAT), U1.19 (VDD), U1.32 (VDD), U1.48 (VDD), U1.64 (VDD); also elsewhere on the board
+5V: D7.1 (K); also elsewhere on the board
/Bus Voltage: U1.11 (PC3); also elsewhere on the board
/CAN1/RX: U1.61 (PB8); also elsewhere on the board
/CAN1/TX: U1.62 (PB9); also elsewhere on the board
/Filters/Curr_U_Out: U1.8 (PC0); also elsewhere on the board
/Filters/Curr_V_Out: U1.9 (PC1); also elsewhere on the board
/Filters/Curr_W_Out: U1.10 (PC2); also elsewhere on the board
/Filters/EN_C: U1.54 (PD2); also elsewhere on the board
/Filters/EN_V: U1.40 (PC9); also elsewhere on the board
/Filters/Volt_U_In: U1.14 (PA0); also elsewhere on the board
/Filters/Volt_V_In: U1.15 (PA1); also elsewhere on the board
/Filters/Volt_W_In: U1.16 (PA2); also elsewhere on the board
/MCU/ADC-15: U1.25 (PC5); also elsewhere on the board
/MCU/FET_Temp_U: U1.17 (PA3); also elsewhere on the board
/MCU/FET_Temp_V: U1.26 (PB0); also elsewhere on the board
/MCU/FET_Temp_W: U1.27 (PB1); also elsewhere on the board
/MCU/H_U: U1.41 (PA8); also elsewhere on the board
/MCU/H_V: U1.42 (PA9); also elsewhere on the board
/MCU/H_W: U1.43 (PA10); also elsewhere on the board
/MCU/Hall U: U1.37 (PC6); also elsewhere on the board
/MCU/Hall V: U1.38 (PC7); also elsewhere on the board
/MCU/Hall W: U1.39 (PC8); also elsewhere on the board
/MCU/LED_GREEN: U1.57 (PB5); also elsewhere on the board
/MCU/LED_RED: U1.59 (PB7); also elsewhere on the board
/MCU/L_U: U1.34 (PB13); also elsewhere on the board
/MCU/L_V: U1.35 (PB14); also elsewhere on the board
/MCU/L_W: U1.36 (PB15); also elsewhere on the board
/MCU/MISO_ADC_EXT2: U1.21 (PA5); also elsewhere on the board
/MCU/NRST: C7.1, R11.2, U1.7 (NRST); also elsewhere on the board
/MCU/RX_SDA_NSS: U1.20 (PA4); also elsewhere on the board
/MCU/SCK_ADC_EXT: U1.22 (PA6); also elsewhere on the board
/MCU/SWCLK: U1.49 (PA14); also elsewhere on the board
/MCU/SWDIO: U1.46 (PA13); also elsewhere on the board
/MCU/TEMP_MOTOR: U1.24 (PC4); also elsewhere on the board
/MCU/TX_SCL_MOSI: U1.29 (PB10); also elsewhere on the board
/MCU/USB_DN: R45.2, U1.44 (PA11)
/MCU/USB_DP: R44.2, U1.45 (PA12)
GND: C1.2, C2.2, C3.2, C4.2, C5.2, C6.2, C7.2, C8.2, C9.2, C10.2, C11.2, C12.2, J12.A12B1 (GND), J12.B12A1 (GND), J12.S1 (SHIELD), R107.1, R108.1, U1.12 (VSSA), U1.18 (VSS), U1.60 (BOOT0), U1.63 (VSS), Y1.2 (G), Y1.4 (G); also elsewhere on the board
unnamed: D7.2 (A), FB3.1
unnamed: F3.1, FB3.2
unnamed: F3.2, J12.A9B4 (VBUS), J12.B9A4 (VBUS)
unnamed: J12.A5 (CC1), R108.2
unnamed: J12.B5 (CC2), R107.2
unnamed: J12.A6 (D+), J12.B6 (D+), R44.1
unnamed: J12.A7 (D-), J12.B7 (D-), R45.1
unnamed: C11.1, U1.5 (PH0), Y1.1
unnamed: C12.1, U1.6 (PH1), Y1.3
unnamed: C10.1, U1.31 (VCAP_1)
unnamed: C9.1, U1.47 (VCAP_2)
unnamed: C1.1, C2.1, R10.2, U1.13 (VDDA)

Parts of its further copies:
C16, C36, C37, C38, C39, C40: 100nF; C_0402_1005Metric; LCSC C307331
C17, C41: 10uF; C_0805_2012Metric; LCSC C440198
C42, C43: 2.2uF; C_0402_1005Metric; LCSC C20539421
C44, C45: 15pF; C_0402_1005Metric; LCSC C1548
D8: BAV16W; D_SOD-123; JLC C459527
F4: 0.5A; R_0805_2012Metric; JLC C2833485
FB4: 600R@100MHz; L_0402_1005Metric; LCSC C76884
J13: Connector, USB-TYPE-C-16P; TYPE-C-SMD_HX-TYPE-C-16PIN; LCSC C2927039
R30: 4.7; R_0402_1005Metric; LCSC C25121
R31: 10k; R_0402_1005Metric; LCSC C25744
R46, R47: 22; R_0402_1005Metric; LCSC C25092
R109, R110: 5.1k; R_0402_1005Metric; LCSC C25905
U4: STM32F405RGTx; LQFP-64_10x10mm_P0.5mm; LCSC C15742
Y2: 8M; Crystal_SMD_3225-4Pin_3.2x2.5mm; JLC C2682775

Connections of its further copies:
+3V3: C36.1, C37.1, C38.1, C39.1, C41.1, R30.1, R31.1, U4.1 (VBAT), U4.19 (VDD), U4.32 (VDD), U4.48 (VDD), U4.64 (VDD); also elsewhere on the board
+5V: D8.1 (K); also elsewhere on the board
/Bus Voltage: U4.11 (PC3); also elsewhere on the board
/CAN2/RX: U4.61 (PB8); also elsewhere on the board
/CAN2/TX: U4.62 (PB9); also elsewhere on the board
/Filters1/Curr_U_Out: U4.8 (PC0); also elsewhere on the board
/Filters1/Curr_V_Out: U4.9 (PC1); also elsewhere on the board
/Filters1/Curr_W_Out: U4.10 (PC2); also elsewhere on the board
/Filters1/EN_C: U4.54 (PD2); also elsewhere on the board
/Filters1/EN_V: U4.40 (PC9); also elsewhere on the board
/Filters1/Volt_U_In: U4.14 (PA0); also elsewhere on the board
/Filters1/Volt_V_In: U4.15 (PA1); also elsewhere on the board
/Filters1/Volt_W_In: U4.16 (PA2); also elsewhere on the board
/MCU1/ADC-15: U4.25 (PC5); also elsewhere on the board
/MCU1/FET_Temp_U: U4.17 (PA3); also elsewhere on the board
/MCU1/FET_Temp_V: U4.26 (PB0); also elsewhere on the board
/MCU1/FET_Temp_W: U4.27 (PB1); also elsewhere on the board
/MCU1/H_U: U4.41 (PA8); also elsewhere on the board
/MCU1/H_V: U4.42 (PA9); also elsewhere on the board
/MCU1/H_W: U4.43 (PA10); also elsewhere on the board
/MCU1/Hall U: U4.37 (PC6); also elsewhere on the board
/MCU1/Hall V: U4.38 (PC7); also elsewhere on the board
/MCU1/Hall W: U4.39 (PC8); also elsewhere on the board
/MCU1/LED_GREEN: U4.57 (PB5); also elsewhere on the board
/MCU1/LED_RED: U4.59 (PB7); also elsewhere on the board
/MCU1/L_U: U4.34 (PB13); also elsewhere on the board
/MCU1/L_V: U4.35 (PB14); also elsewhere on the board
/MCU1/L_W: U4.36 (PB15); also elsewhere on the board
/MCU1/MISO_ADC_EXT2: U4.21 (PA5); also elsewhere on the board
/MCU1/NRST: C40.1, R31.2, U4.7 (NRST); also elsewhere on the board
/MCU1/RX_SDA_NSS: U4.20 (PA4); also elsewhere on the board
/MCU1/SCK_ADC_EXT: U4.22 (PA6); also elsewhere on the board
/MCU1/SWCLK: U4.49 (PA14); also elsewhere on the board
/MCU1/SWDIO: U4.46 (PA13); also elsewhere on the board
/MCU1/TEMP_MOTOR: U4.24 (PC4); also elsewhere on the board
/MCU1/TX_SCL_MOSI: U4.29 (PB10); also elsewhere on the board
/MCU1/USB_DN: R47.2, U4.44 (PA11)
/MCU1/USB_DP: R46.2, U4.45 (PA12)
GND: C16.2, C17.2, C36.2, C37.2, C38.2, C39.2, C40.2, C41.2, C42.2, C43.2, C44.2, C45.2, J13.A12B1 (GND), J13.B12A1 (GND), J13.S1 (SHIELD), R109.1, R110.1, U4.12 (VSSA), U4.18 (VSS), U4.60 (BOOT0), U4.63 (VSS), Y2.2 (G), Y2.4 (G); also elsewhere on the board
unnamed: D8.2 (A), FB4.1
unnamed: F4.1, FB4.2
unnamed: F4.2, J13.A9B4 (VBUS), J13.B9A4 (VBUS)
unnamed: J13.A5 (CC1), R110.2
unnamed: J13.B5 (CC2), R109.2
unnamed: J13.A6 (D+), J13.B6 (D+), R46.1
unnamed: J13.A7 (D-), J13.B7 (D-), R47.1
unnamed: C44.1, U4.5 (PH0), Y2.1
unnamed: C45.1, U4.6 (PH1), Y2.3
unnamed: C43.1, U4.31 (VCAP_1)
unnamed: C42.1, U4.47 (VCAP_2)
unnamed: C16.1, C17.1, R30.2, U4.13 (VDDA)

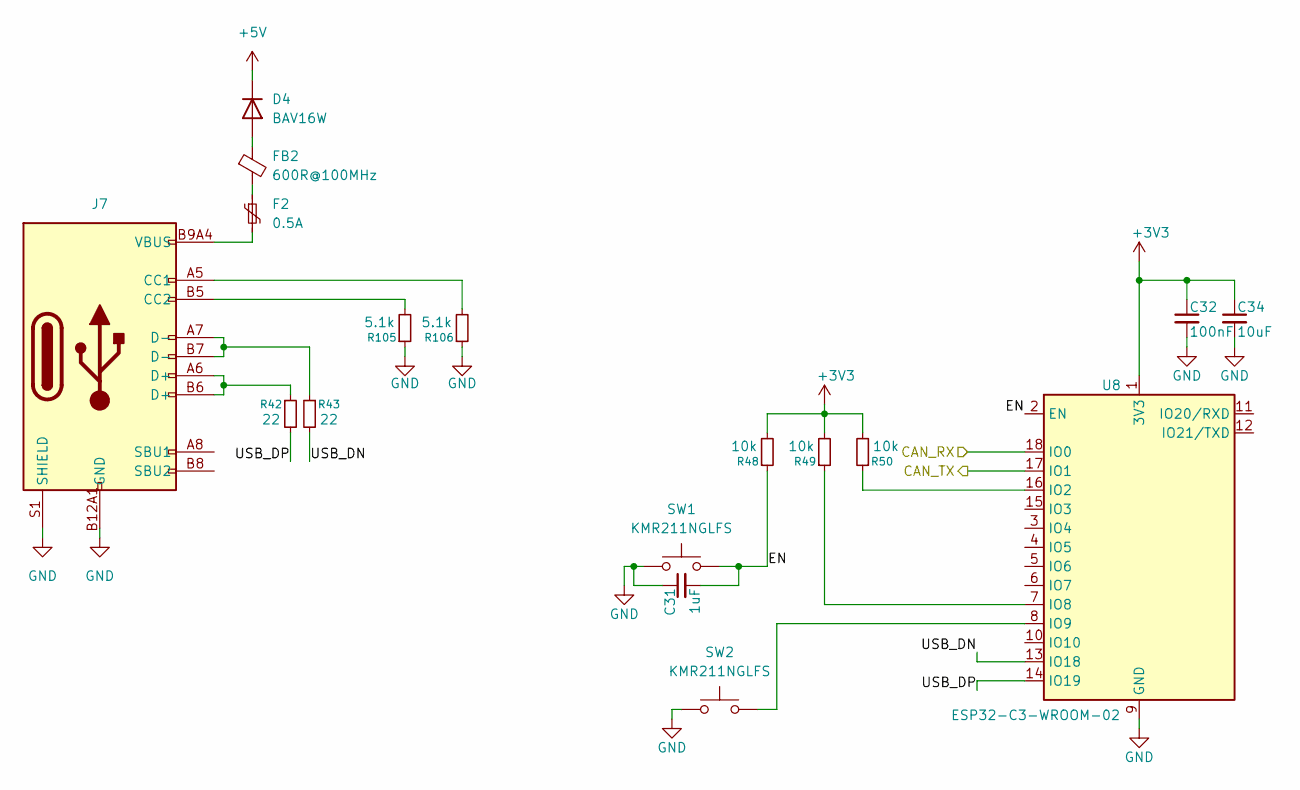
[picture p9: schematic ESP.kicad_sch, Twin-GaN]

Parts:
C31: 1uF; C_0402_1005Metric; LCSC C52923
C32: 100nF; C_0402_1005Metric; LCSC C307331
C34: 10uF; C_0805_2012Metric; LCSC C440198
D4: BAV16W; D_SOD-123; JLC C459527
F2: 0.5A; R_0805_2012Metric; JLC C2833485
FB2: 600R@100MHz; L_0402_1005Metric; LCSC C76884
J7: Connector, USB-TYPE-C-16P; TYPE-C-SMD_HX-TYPE-C-16PIN; LCSC C2927039
R42, R43: 22; R_0402_1005Metric; LCSC C25092
R48, R49, R50: 10k; R_0402_1005Metric; LCSC C25744
R105, R106: 5.1k; R_0402_1005Metric; LCSC C25905
SW1, SW2: KMR211NGLFS; SW_Push_1P1T_NO_CK_KMR2; JLC C221676
U8: ESP32-C3-WROOM-02; JLC C2934560

Connections:
+3V3: C32.1, C34.1, R48.2, R49.2, R50.2, U8.1 (3V3); also elsewhere on the board
+5V: D4.1 (K); also elsewhere on the board
/CAN/RX: U8.18 (IO0); also elsewhere on the board
/CAN/TX: U8.17 (IO1); also elsewhere on the board
/ESP/EN: C31.2, R48.1, SW1.2, U8.2 (EN)
/ESP/USB_DN: R43.2, U8.13 (IO18)
/ESP/USB_DP: R42.2, U8.14 (IO19)
GND: C31.1, C32.2, C34.2, J7.A12B1 (GND), J7.B12A1 (GND), J7.S1 (SHIELD), R105.1, R106.1, SW1.1, SW2.1, U8.9 (GND), U8.19 (GND); also elsewhere on the board
unnamed: D4.2 (A), FB2.1
unnamed: F2.1, FB2.2
unnamed: F2.2, J7.A9B4 (VBUS), J7.B9A4 (VBUS)
unnamed: J7.A5 (CC1), R106.2
unnamed: J7.B5 (CC2), R105.2
unnamed: J7.A6 (D+), J7.B6 (D+), R42.1
unnamed: J7.A7 (D-), J7.B7 (D-), R43.1
unnamed: R50.1, U8.16 (IO2)
unnamed: R49.1, U8.7 (IO8)
unnamed: SW2.2, U8.8 (IO9)

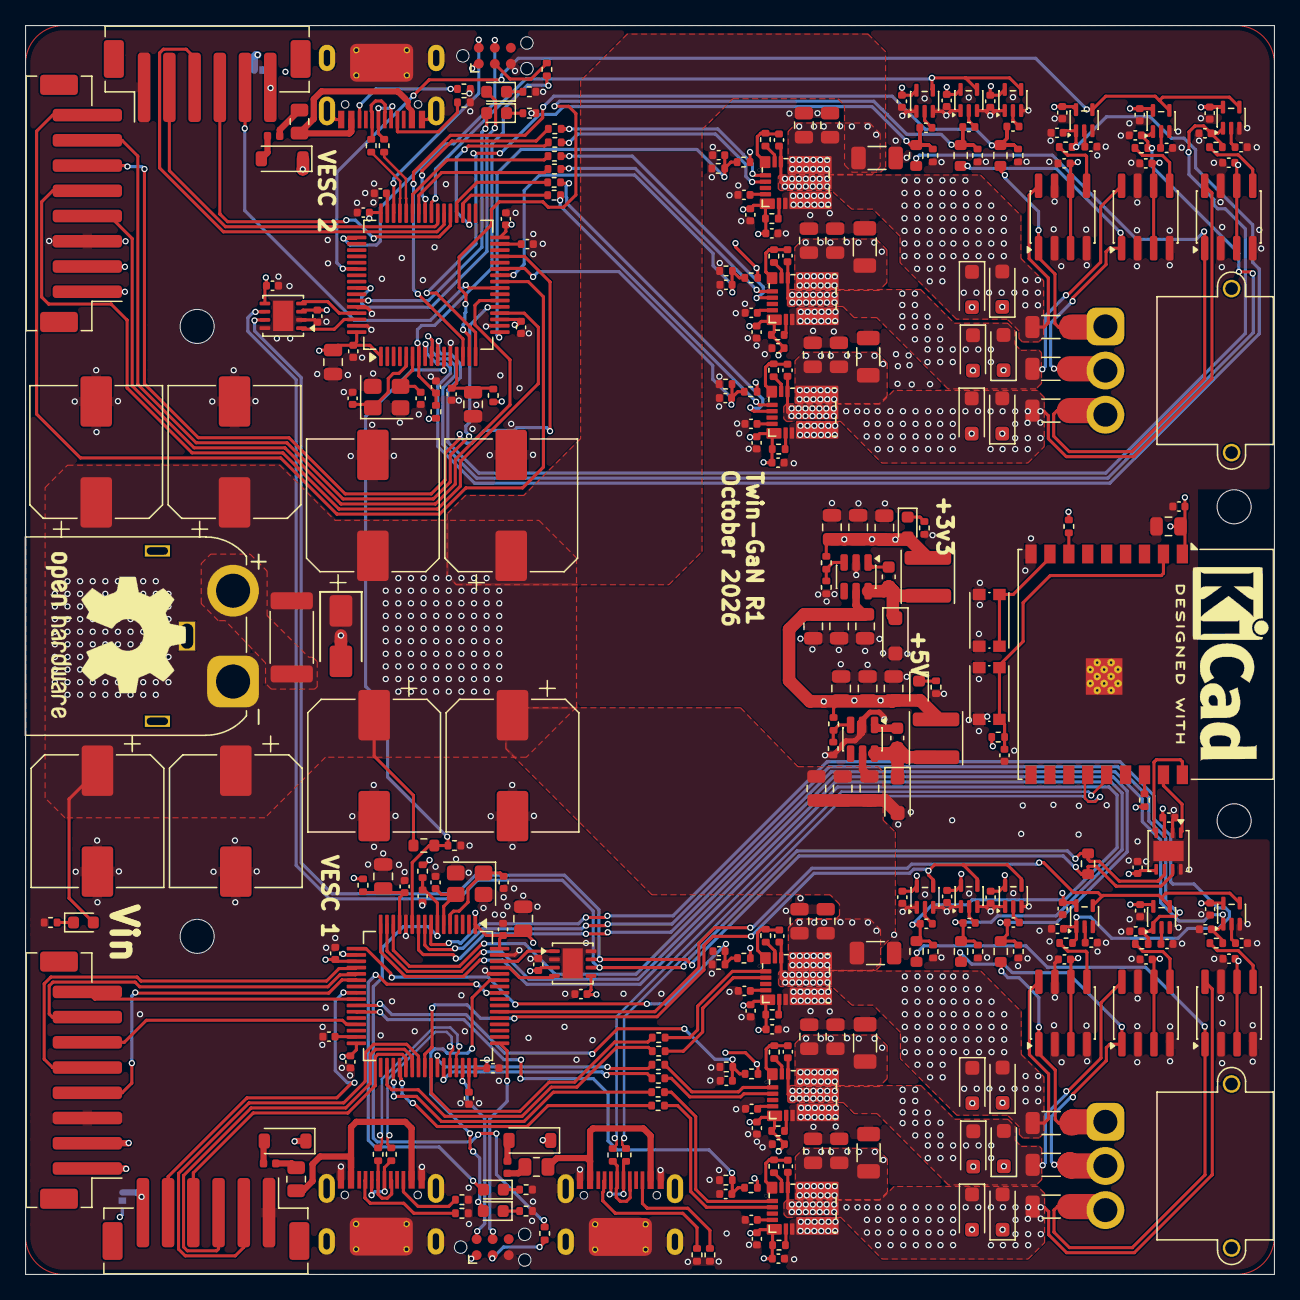
[picture p10: board Twin-GaN-VESC.kicad_pcb from above]

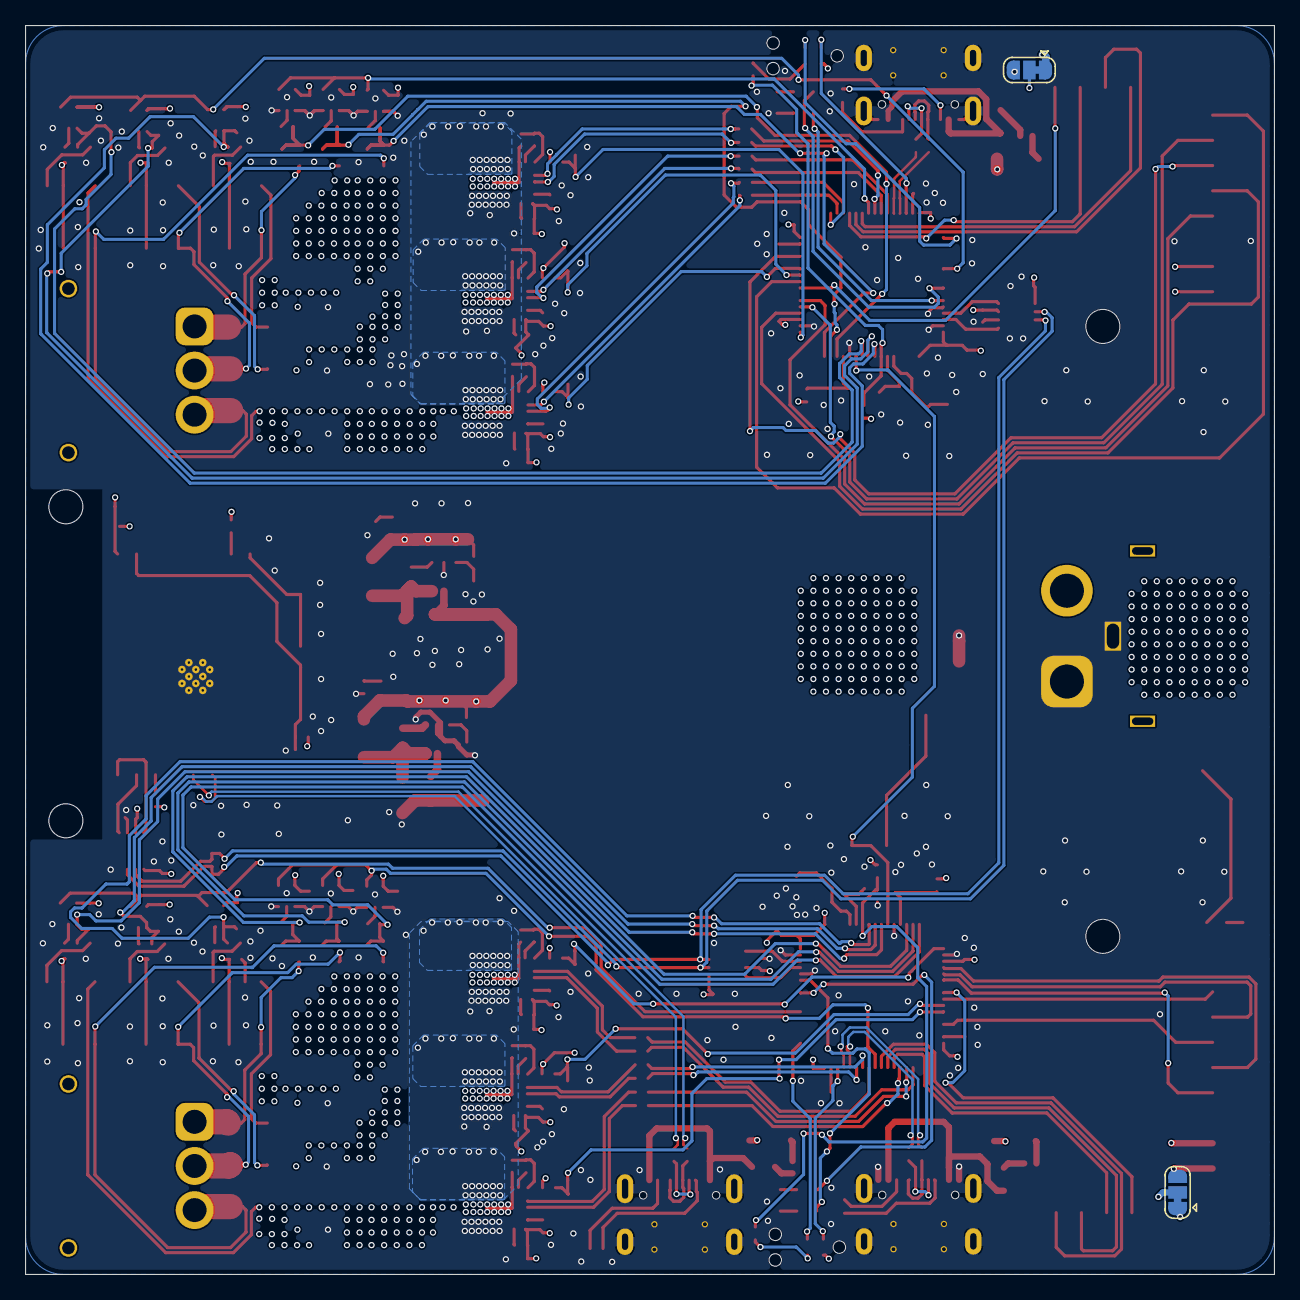
[picture p11: board Twin-GaN-VESC.kicad_pcb from below]

Board: 4 copper layers, 99.0 x 99.0 mm, 322 parts (2 on the bottom side), 200 nets.
