NovaPrime18/Twin-GaN/(notices)

Notices in the files:
README.md:
License: CERN-OHL-S v2.0
